ipaud/bolabol/codi/brand/boli.png

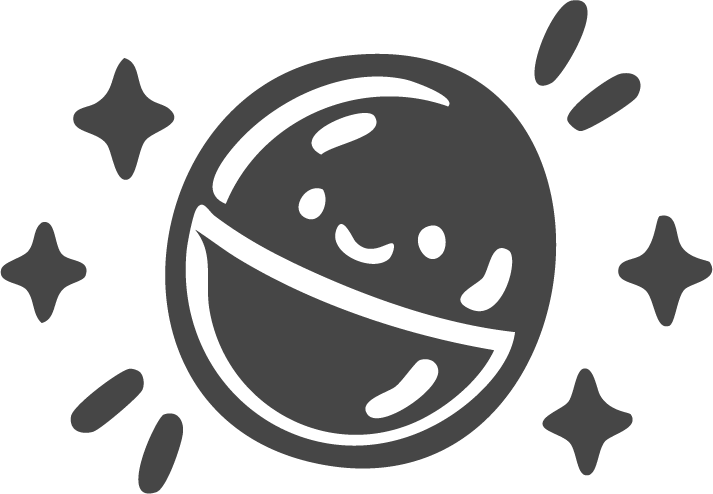
codi/brand/boli.png
