ipaud/bolabol/codi/brand/token_faces_preview.png

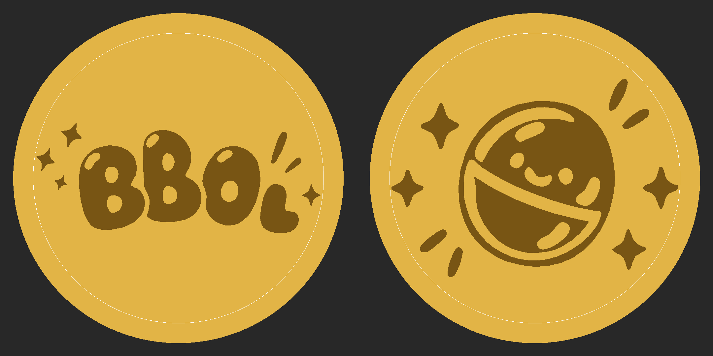
codi/brand/token_faces_preview.png
