ipaud/bolabol/docs/blueprints/despiece-v4.jpg

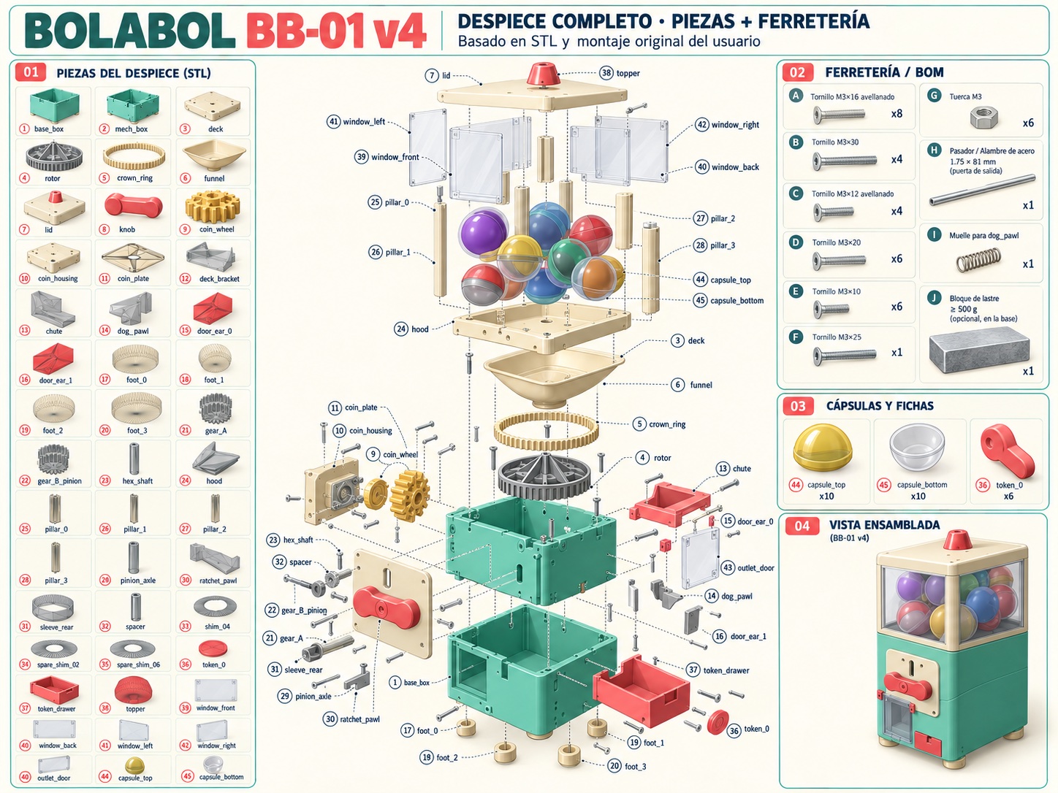
docs/blueprints/despiece-v4.jpg
