ipaud/bolabol/docs/blueprints/ficha-v4.jpg

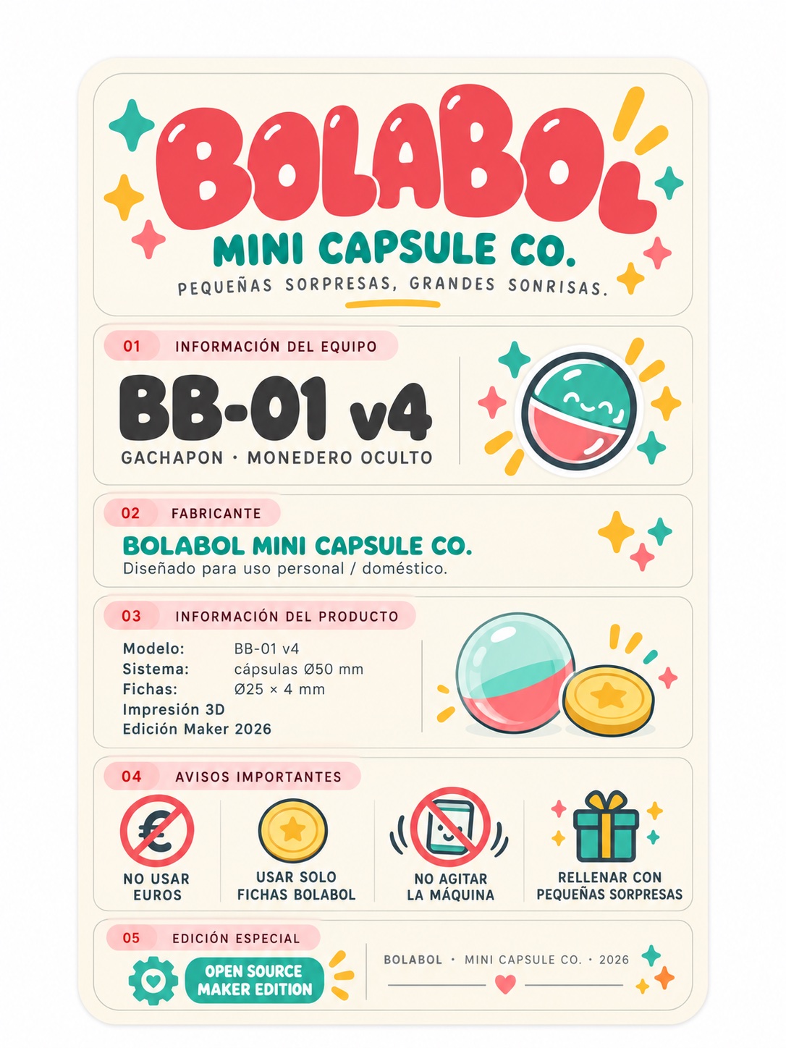
docs/blueprints/ficha-v4.jpg
