ipaud/bolabol/docs/blueprints/manivela-v1.jpg

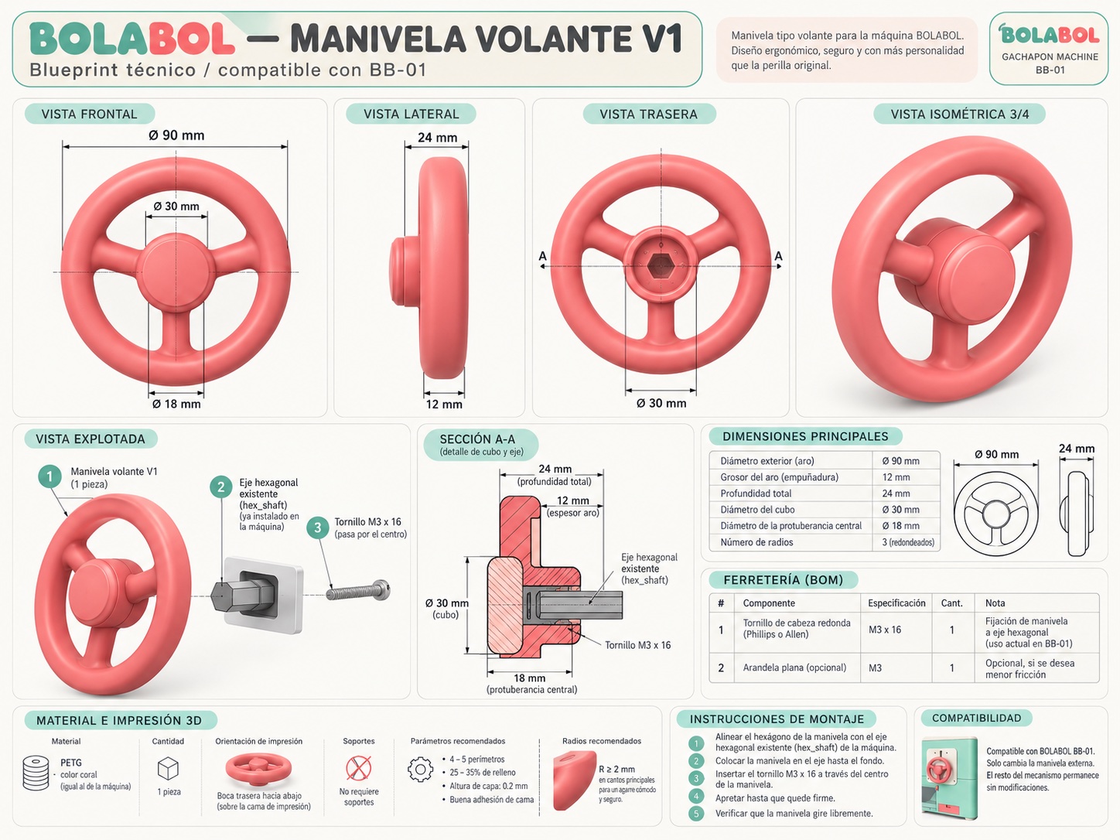
docs/blueprints/manivela-v1.jpg
