ipaud/bolabol/docs/brand/branding-maquina-paleta.jpg

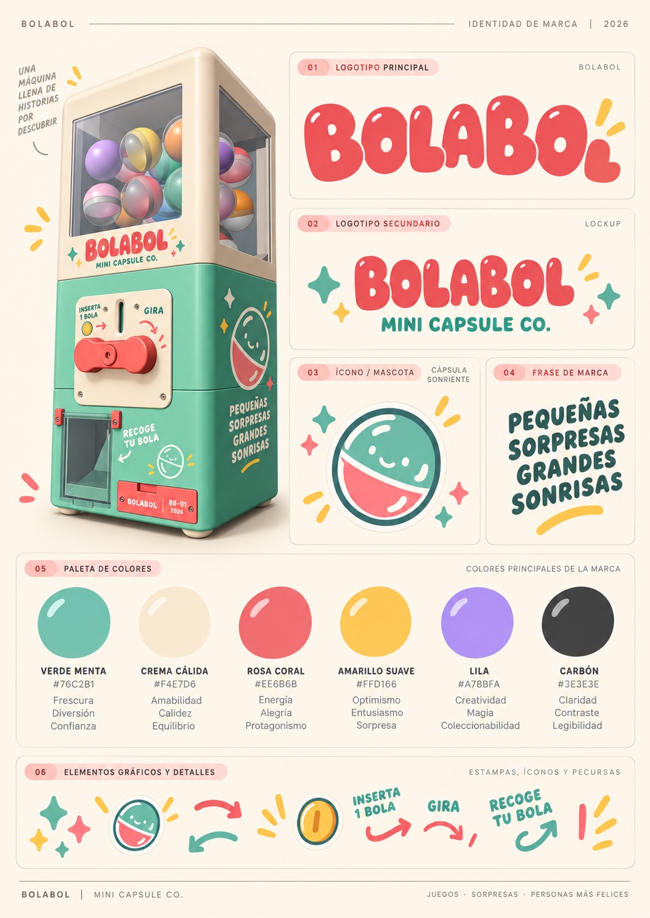
docs/brand/branding-maquina-paleta.jpg
