ipaud/bolabol/docs/brand/maquina-banana.jpg

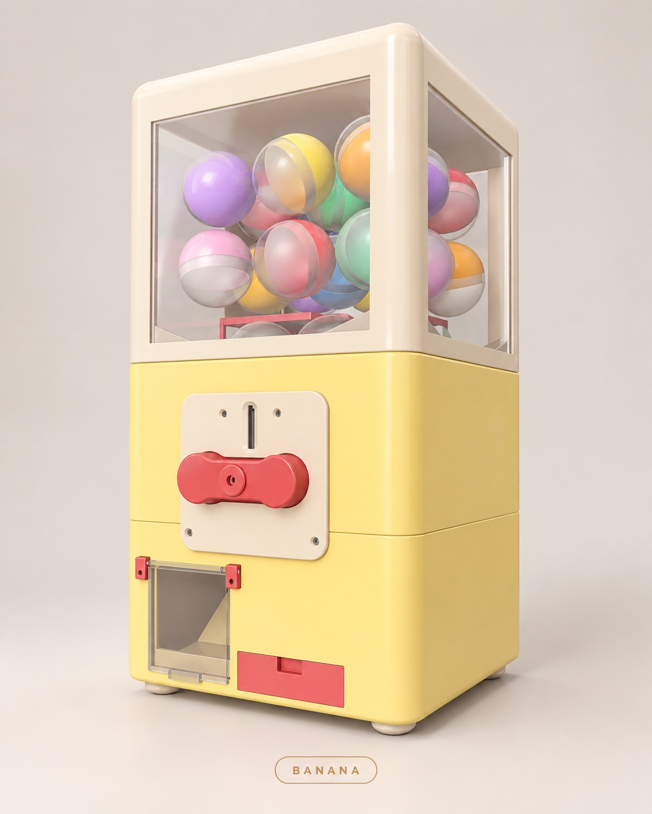
docs/brand/maquina-banana.jpg
