ipaud/bolabol/docs/brand/maquina-lavender.jpg

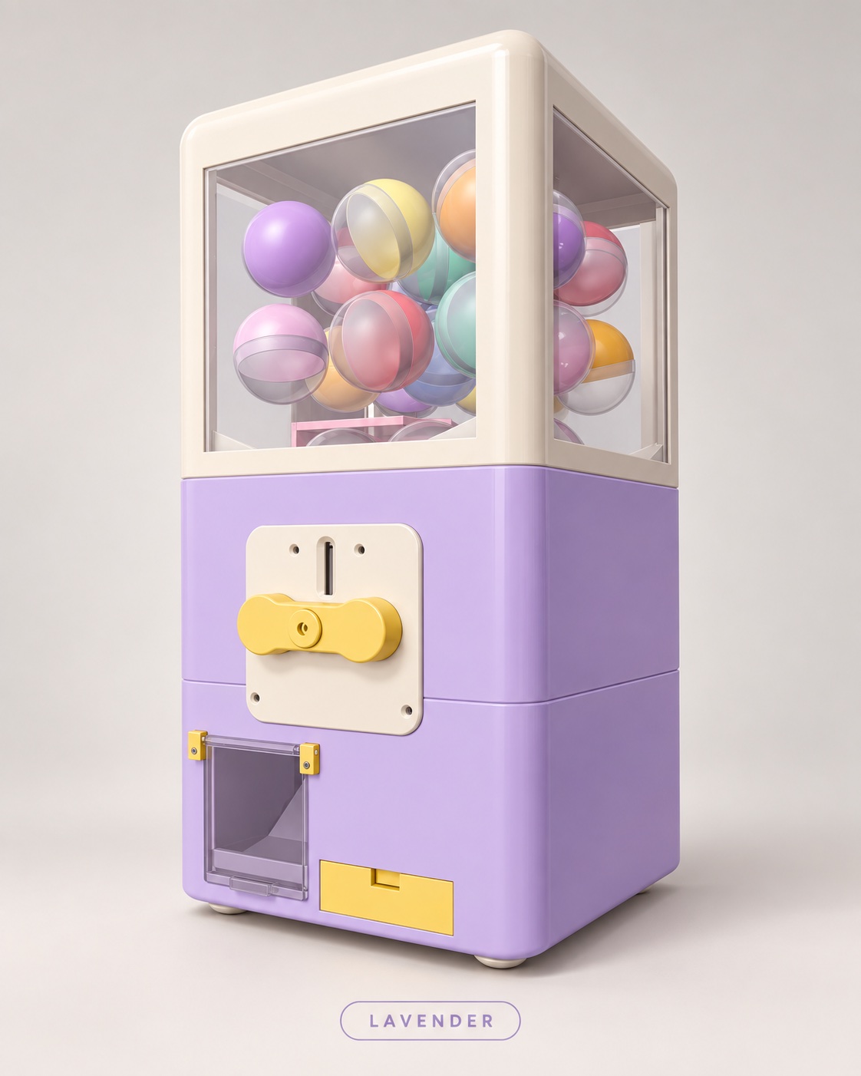
docs/brand/maquina-lavender.jpg
