ipaud/bolabol/docs/brand/maquina-mint.jpg

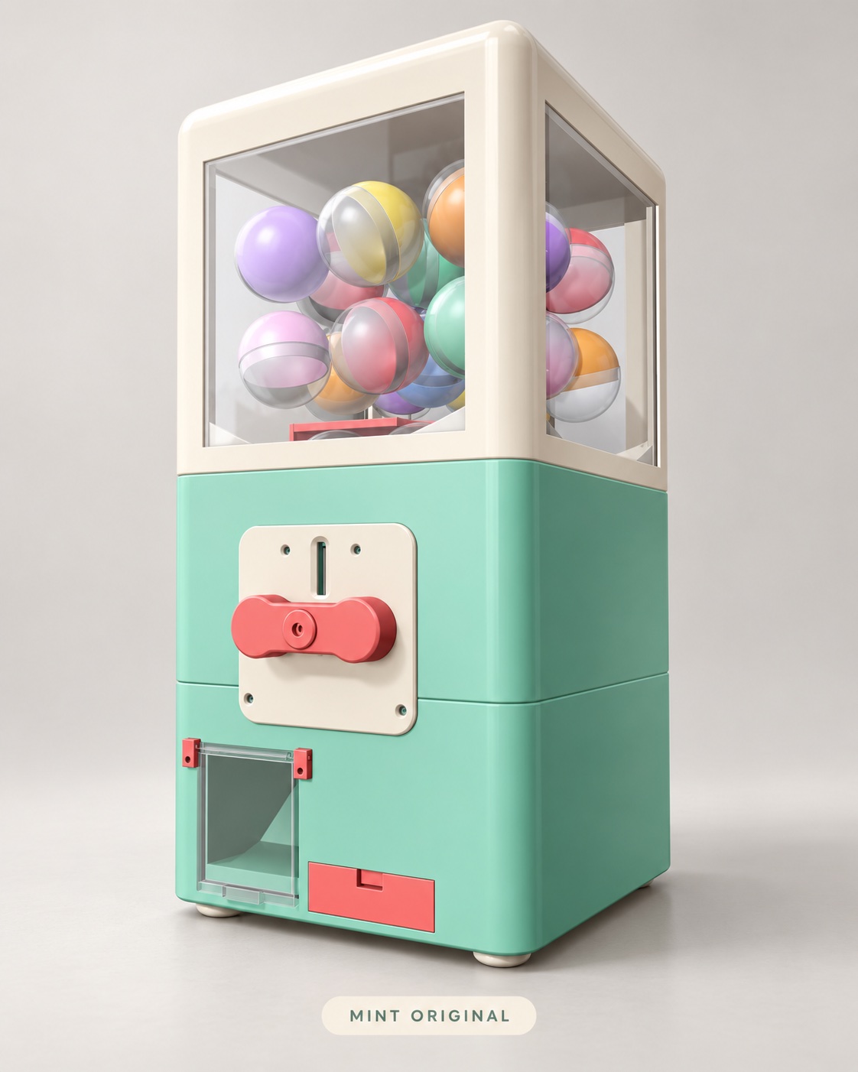
docs/brand/maquina-mint.jpg
