ipaud/bolabol/docs/brand/maquina-night.jpg

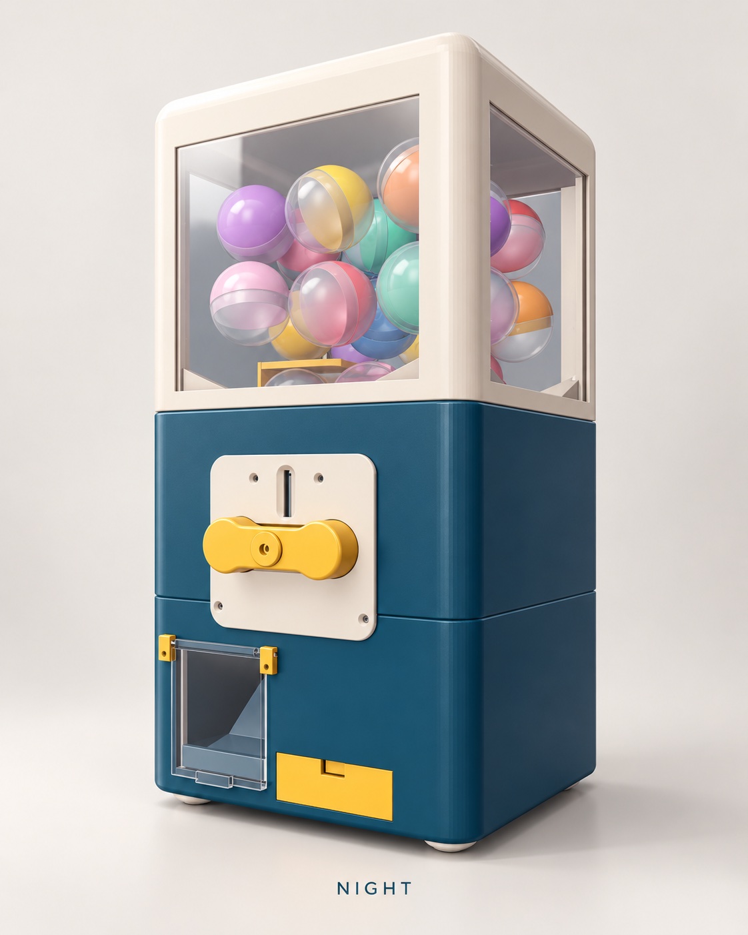
docs/brand/maquina-night.jpg
