ipaud/bolabol/docs/brand/maquina-sky.jpg

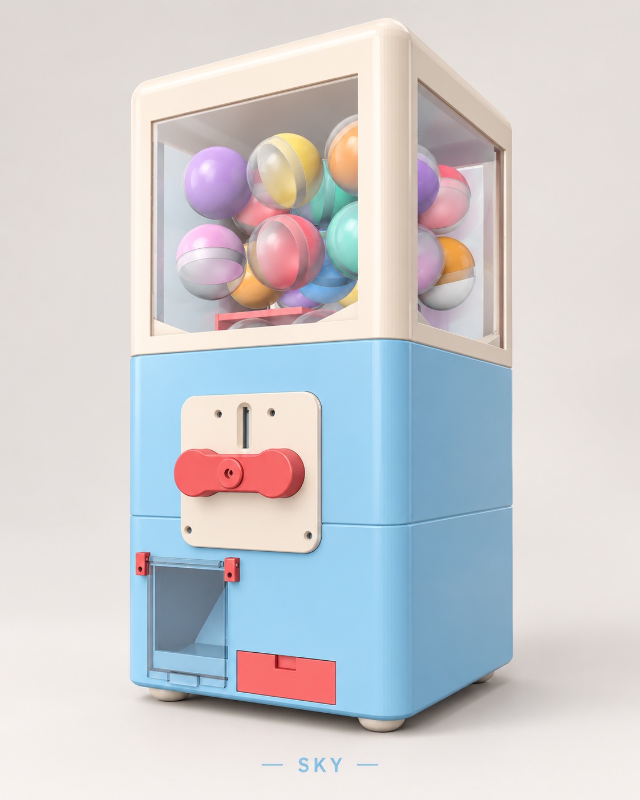
docs/brand/maquina-sky.jpg
