ipaud/bolabol/docs/brand/mascota-expresiones.jpg

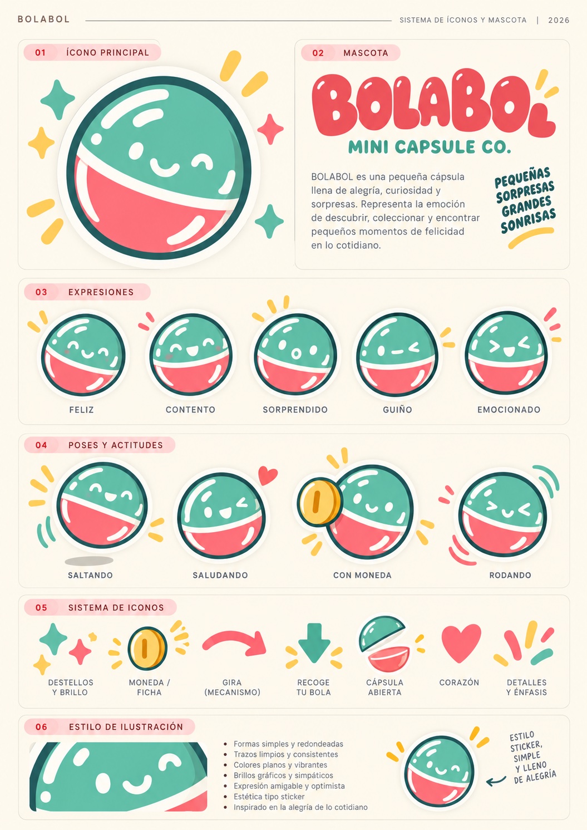
docs/brand/mascota-expresiones.jpg
