ipaud/bolabol/docs/brand/poster-maquina.jpg

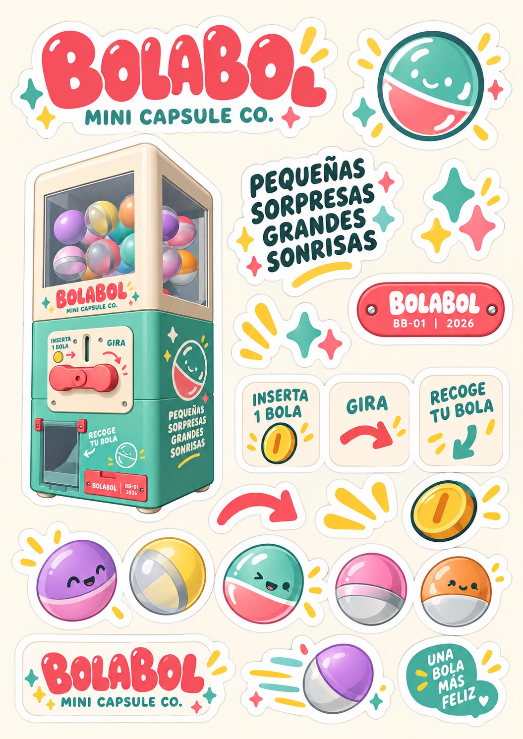
docs/brand/poster-maquina.jpg
