ipaud/bolabol/docs/brand/sistema-tipografico.jpg

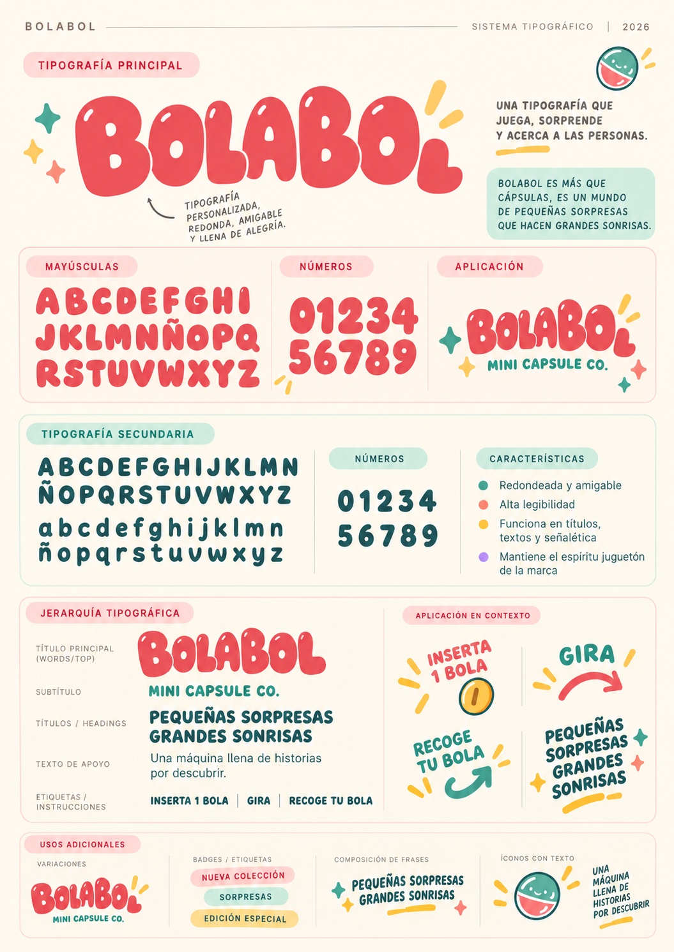
docs/brand/sistema-tipografico.jpg
