ipaud/bolabol/docs/images/v4_moneda.jpg

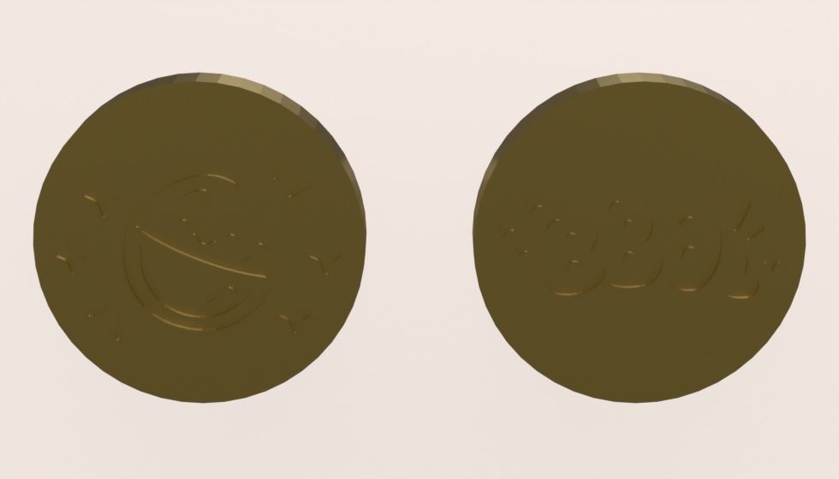
docs/images/v4_moneda.jpg
