ipaud/bolabol/2monedes/mech_box.stl

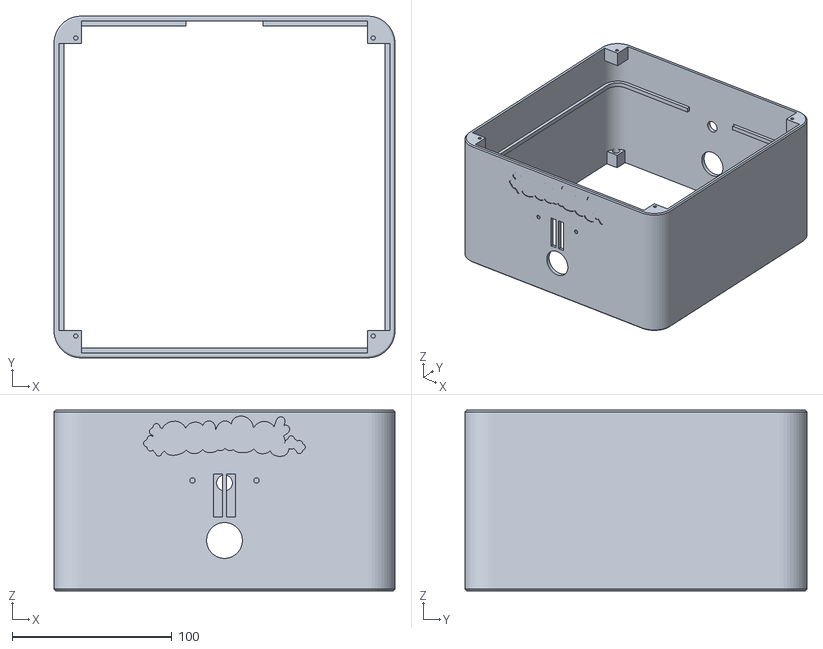
[picture p20: CAD file, 2026-10-04]
2monedes/mech_box.stl
213.4 x 213.9 x 113.0
