ipaud/bolabol/2monedes/proves/proves_5_moneda_A_PLA.3mf

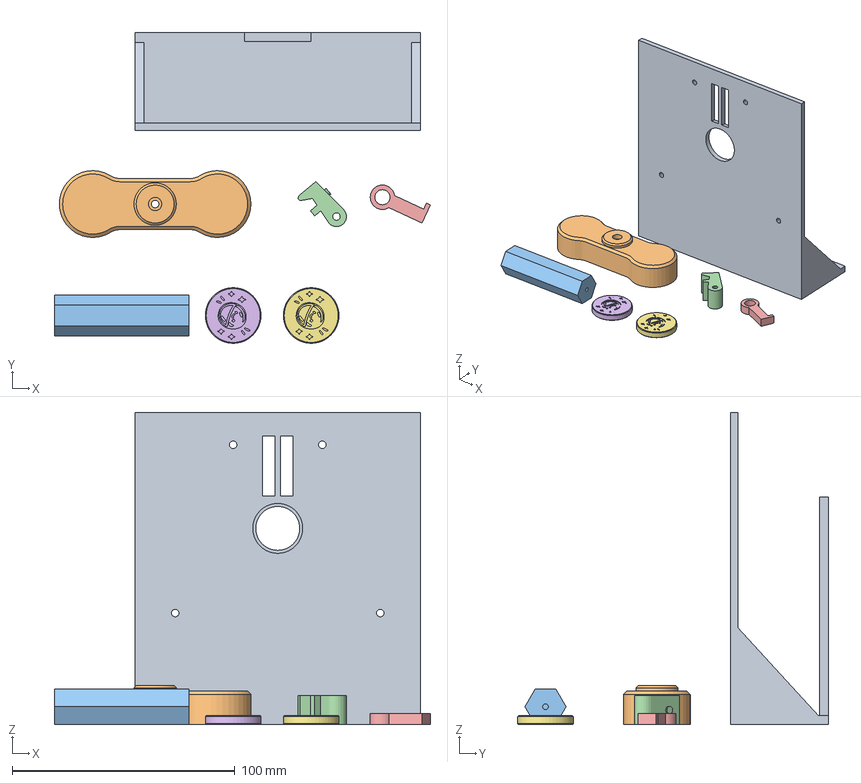
[picture p21: CAD file, 2026-10-04]
2monedes/proves/proves_5_moneda_A_PLA.3mf
168.7 x 139.4 x 140.0 mm
test_coin_jig
knob
test_hex_coupon_coin
dog_pawl
ratchet_pawl
token_0
token_0_b
