ipaud/bolabol/imprimir/llits/llit_11_mecanisme.3mf

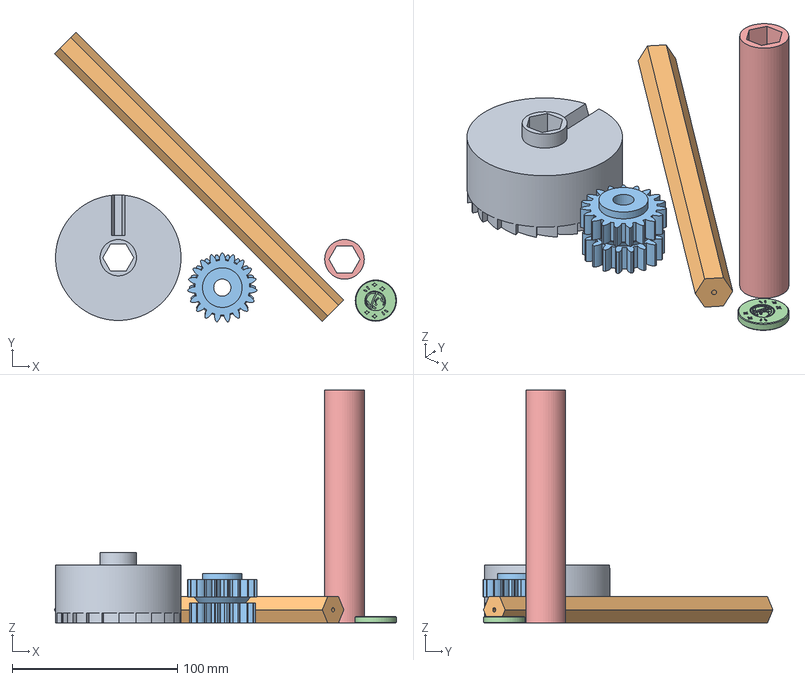
[picture p22: CAD file, 2026-10-04]
imprimir/llits/llit_11_mecanisme.3mf
207.1 x 175.5 x 141.1 mm
coin_wheel
hex_shaft
gear_B_pinion
token_0_6
spacer
