ipaud/bolabol/imprimir/logo_sparkles_mint.stl

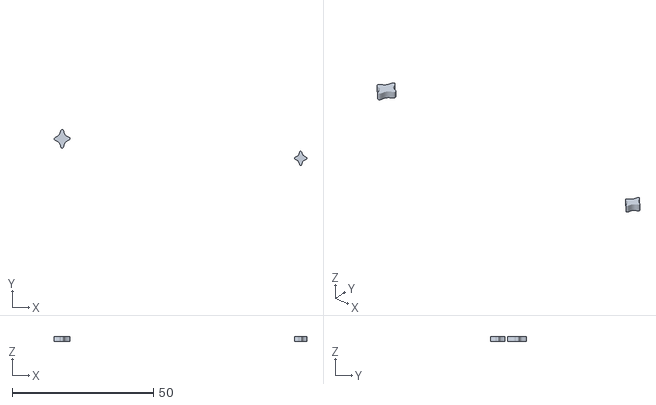
[picture p23: CAD file, 2026-10-04]
imprimir/logo_sparkles_mint.stl
89.5 x 12.8 x 1.80
