ipaud/bolabol/stl/proves/proves_6_moneda_B.3mf

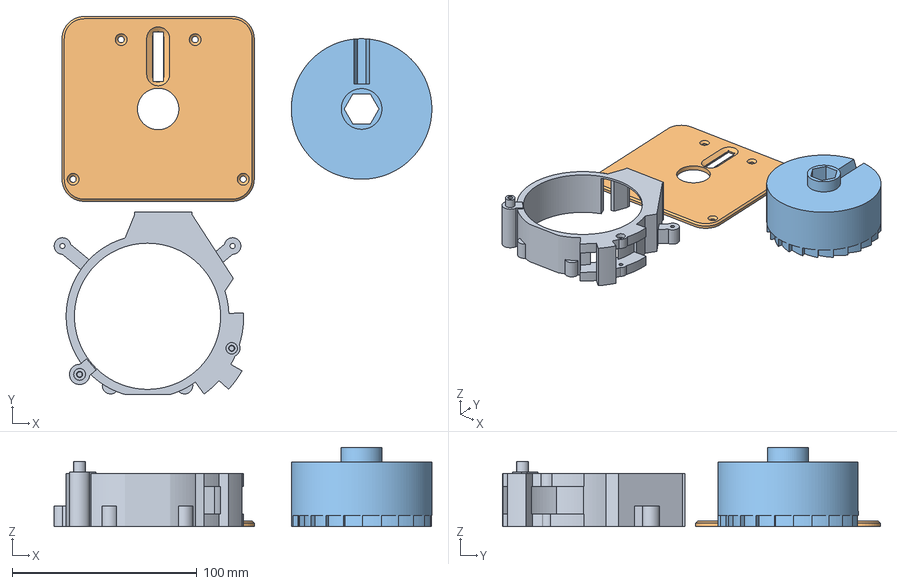
[picture p24: CAD file, 2026-10-04]
stl/proves/proves_6_moneda_B.3mf
204.2 x 204.4 x 42.8 mm
coin_housing
coin_plate
coin_wheel
