ipaud/bolabol/stl/spacer.stl

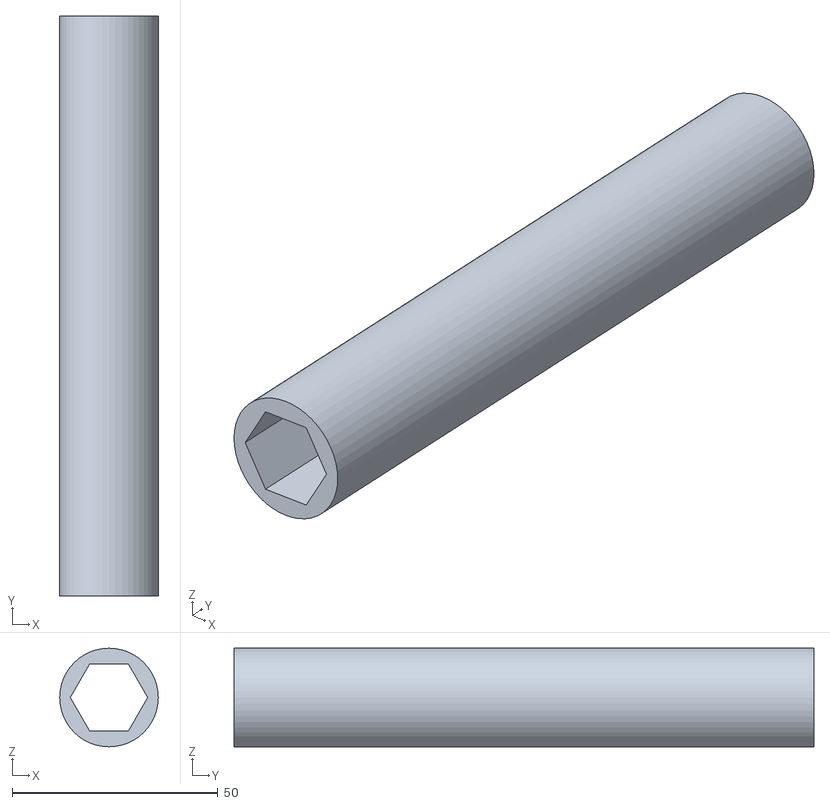
[picture p25: CAD file, 2026-10-04]
stl/spacer.stl
24.0 x 141.1 x 24.0
