ipaud/bolabol/2monedes/coin_plate.stl

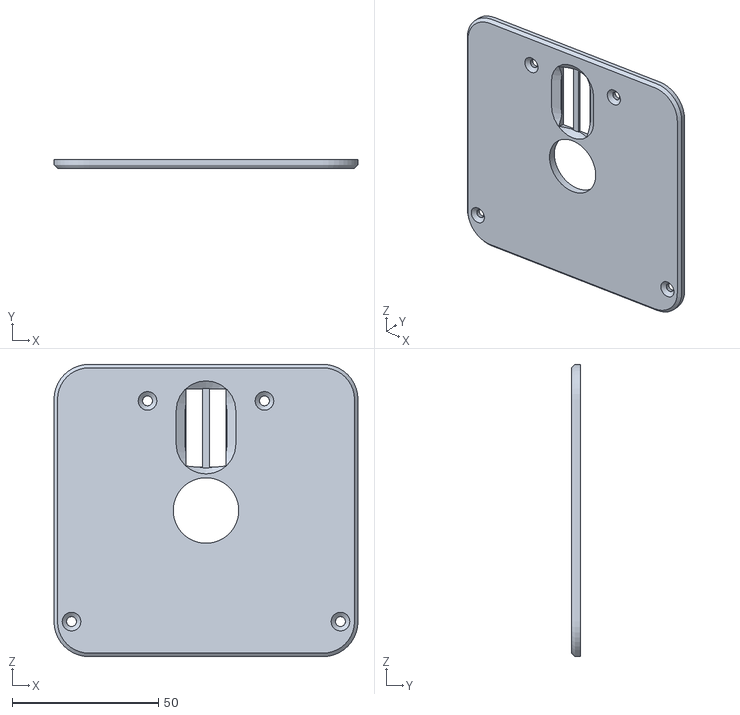
[picture p26: CAD file, 2026-10-04]
2monedes/coin_plate.stl
104.0 x 3.00 x 100.0
