ipaud/bolabol/2monedes/proves/proves_6_moneda_B_PLA.3mf

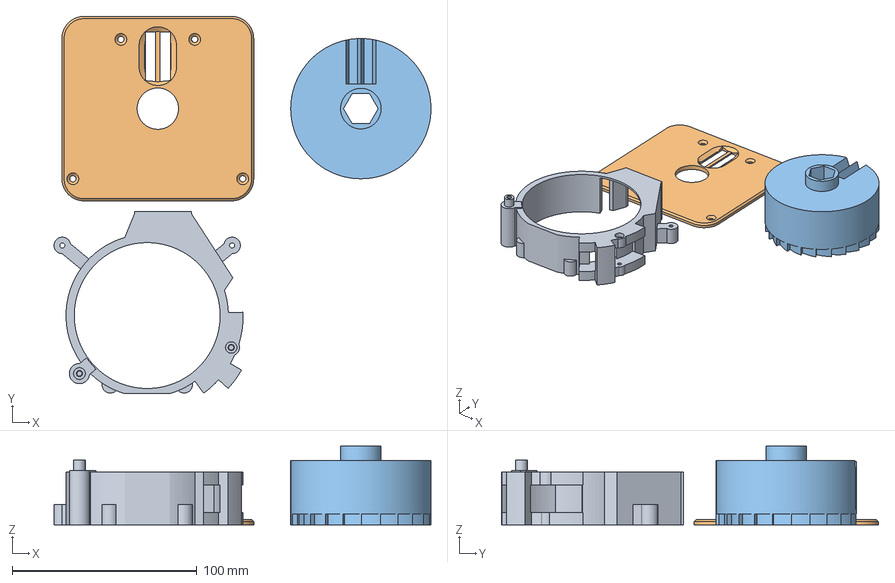
[picture p27: CAD file, 2026-10-04]
2monedes/proves/proves_6_moneda_B_PLA.3mf
204.2 x 204.4 x 42.8 mm
coin_housing
coin_plate
coin_wheel
