ipaud/bolabol/imprimir/llits/llit_18_corall.3mf

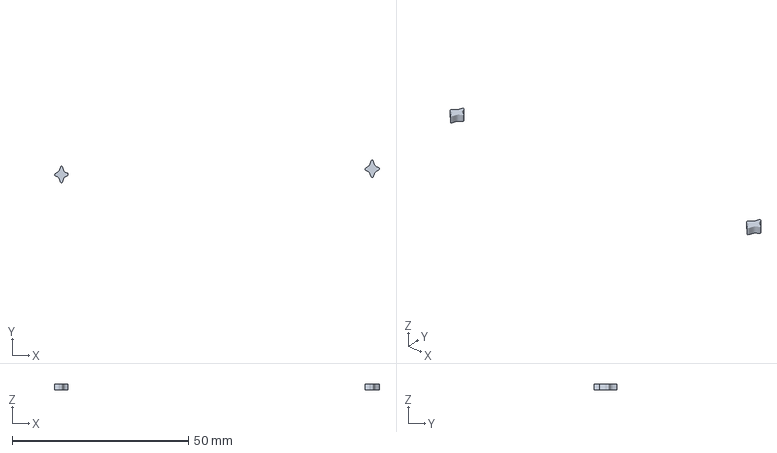
[picture p28: CAD file, 2026-10-04]
imprimir/llits/llit_18_corall.3mf
92.1 x 6.57 x 1.80 mm
