ipaud/bolabol/stl/gear_A.stl

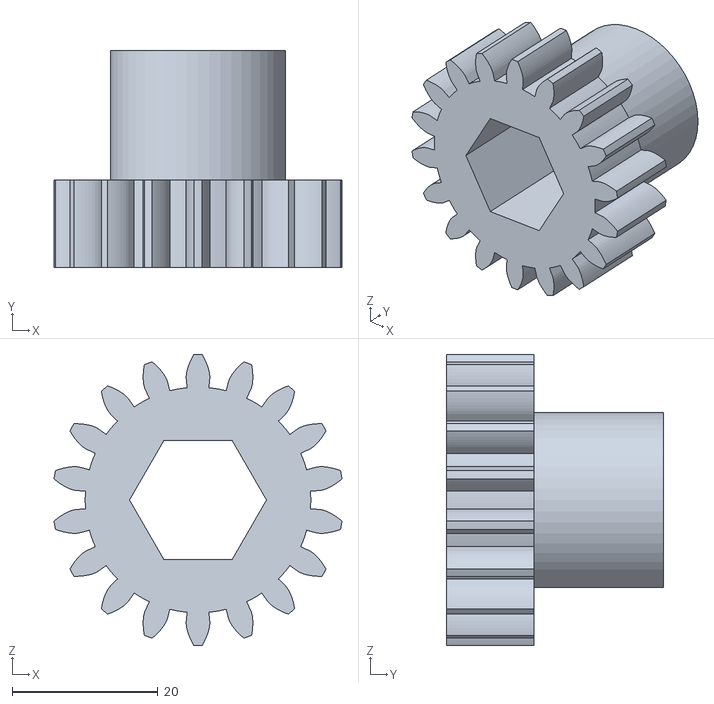
[picture p29: CAD file, 2026-10-04]
stl/gear_A.stl
39.6 x 29.8 x 40.0
