ipaud/bolabol/stl/proves/test_hex_coupon_gears.stl

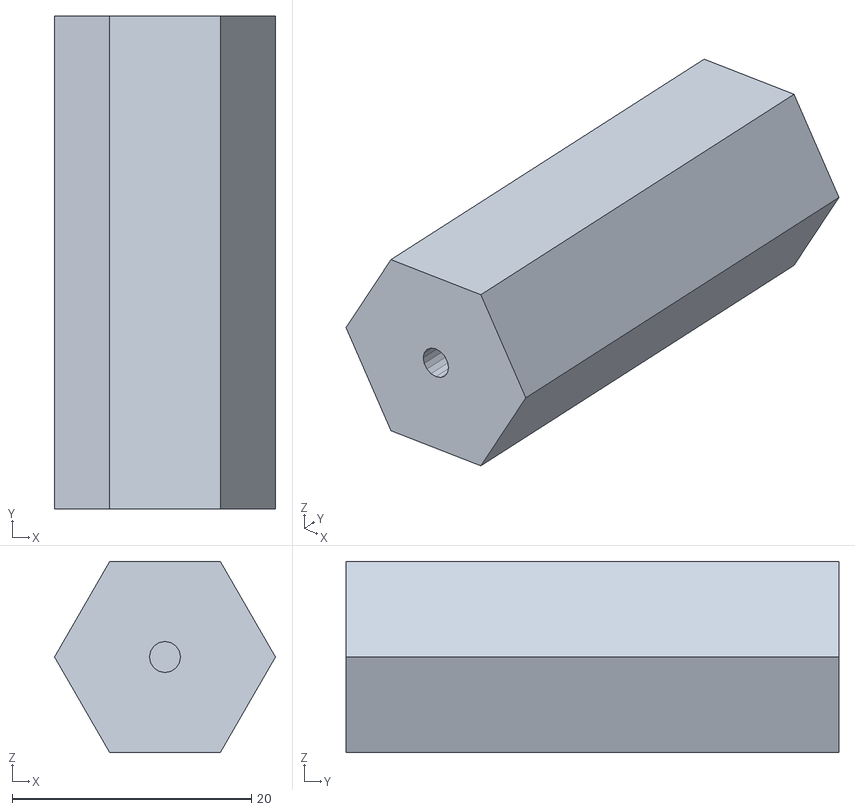
[picture p30: CAD file, 2026-10-04]
stl/proves/test_hex_coupon_gears.stl
18.5 x 41.2 x 16.0
