ipaud/bolabol/2monedes/coin_wheel.stl

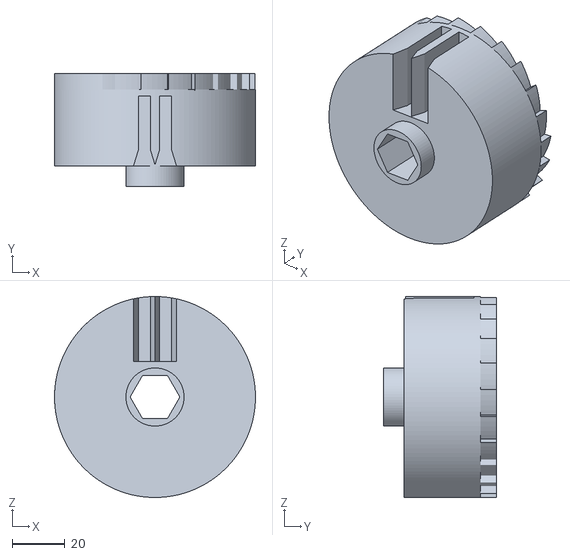
[picture p31: CAD file, 2026-10-04]
2monedes/coin_wheel.stl
76.0 x 42.8 x 76.0
