ipaud/bolabol/2monedes/proves/test_coin_jig.stl

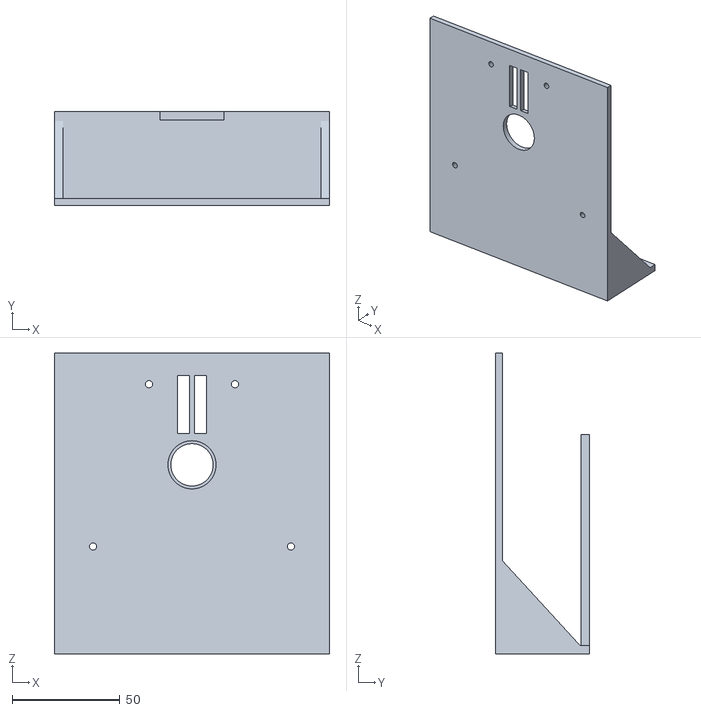
[picture p32: CAD file, 2026-10-04]
2monedes/proves/test_coin_jig.stl
128.0 x 43.8 x 140.0
