ipaud/bolabol/imprimir/coin_housing.stl

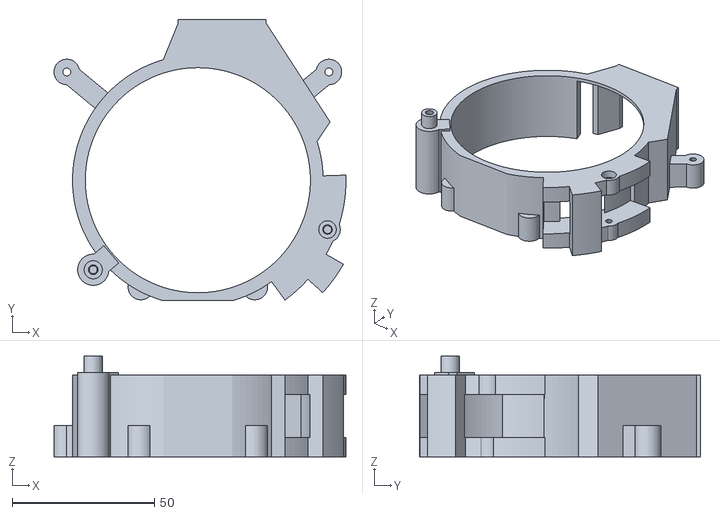
[picture p33: CAD file, 2026-10-04]
imprimir/coin_housing.stl
102.5 x 98.8 x 35.3
