ipaud/bolabol/imprimir/llits/llit_16_groc.3mf

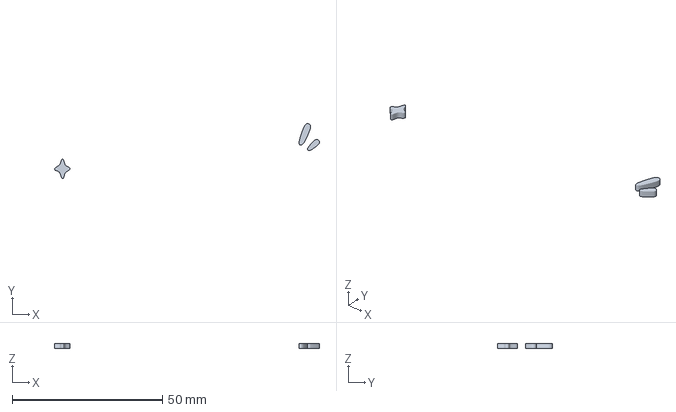
[picture p34: CAD file, 2026-10-04]
imprimir/llits/llit_16_groc.3mf
88.2 x 18.3 x 1.80 mm
