ipaud/bolabol/stl/pillar_2.stl

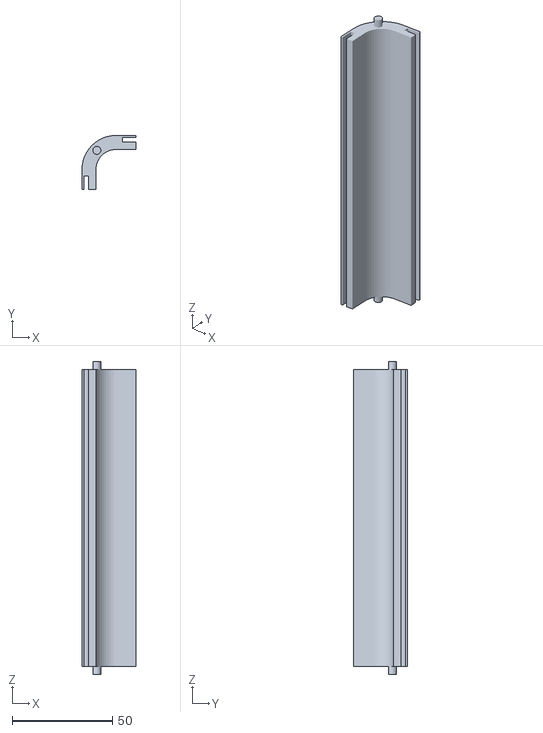
[picture p35: CAD file, 2026-10-04]
stl/pillar_2.stl
27.0 x 27.0 x 156.0
