ipaud/bolabol/stl/proves/test_hex_coupon_coin.stl

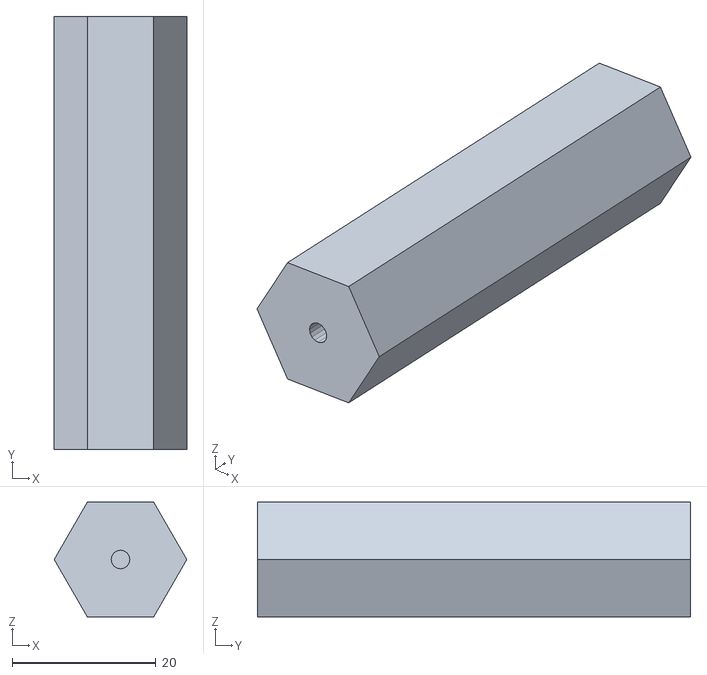
[picture p36: CAD file, 2026-10-04]
stl/proves/test_hex_coupon_coin.stl
18.5 x 60.3 x 16.0
