ipaud/bolabol/imprimir/llits/llit_12_transparent.3mf

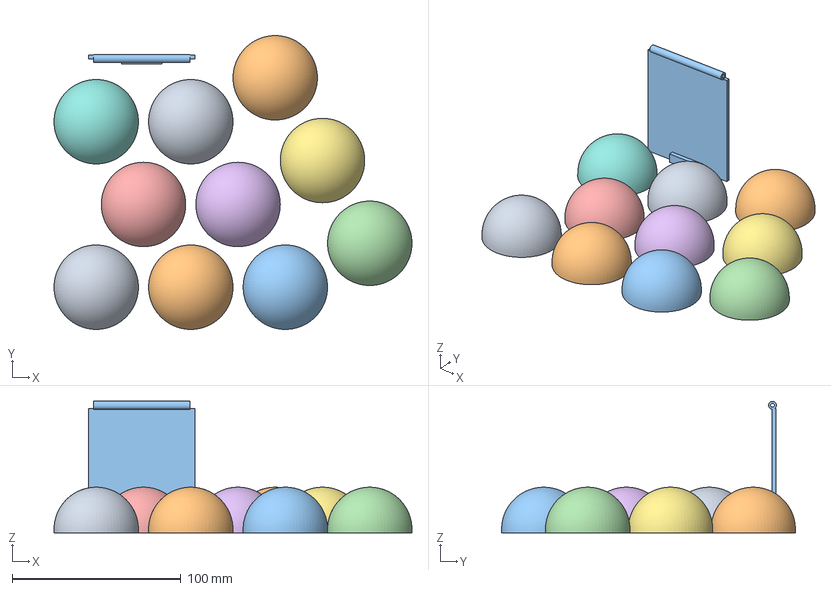
[picture p37: CAD file, 2026-10-04]
imprimir/llits/llit_12_transparent.3mf
212.0 x 174.0 x 77.9 mm
capsule_top
capsule_top_2
capsule_top_3
capsule_top_4
capsule_top_5
capsule_top_6
capsule_top_7
capsule_top_8
capsule_top_9
capsule_top_10
outlet_door
