ipaud/bolabol/stl/proves/test_gear_jig.stl

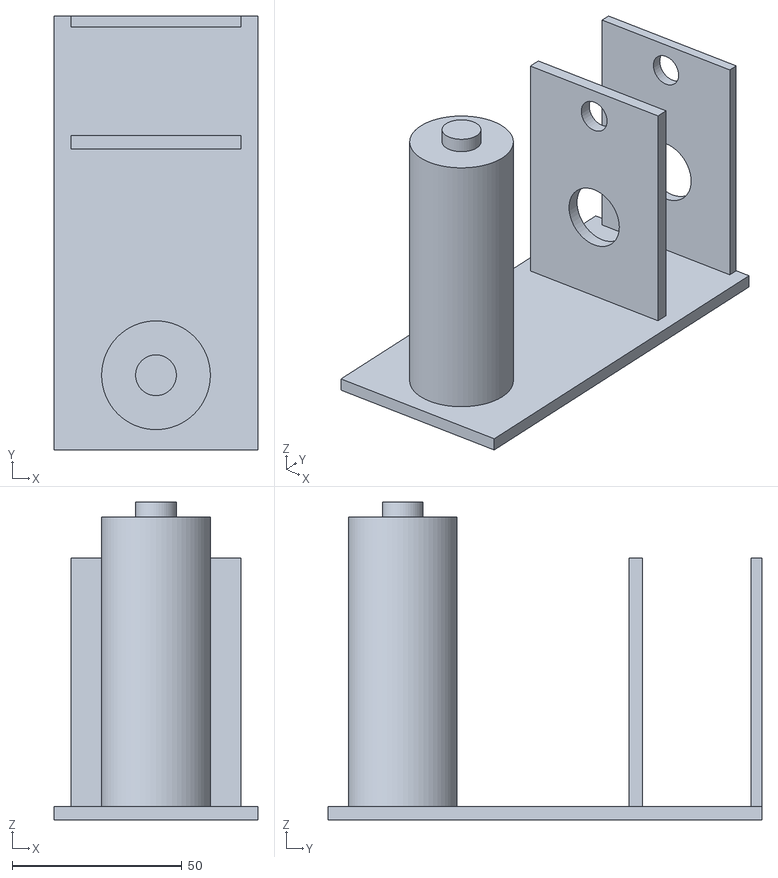
[picture p38: CAD file, 2026-10-04]
stl/proves/test_gear_jig.stl
60.0 x 127.7 x 93.5
