ipaud/bolabol/imprimir/llits/llit_19_monedes.3mf

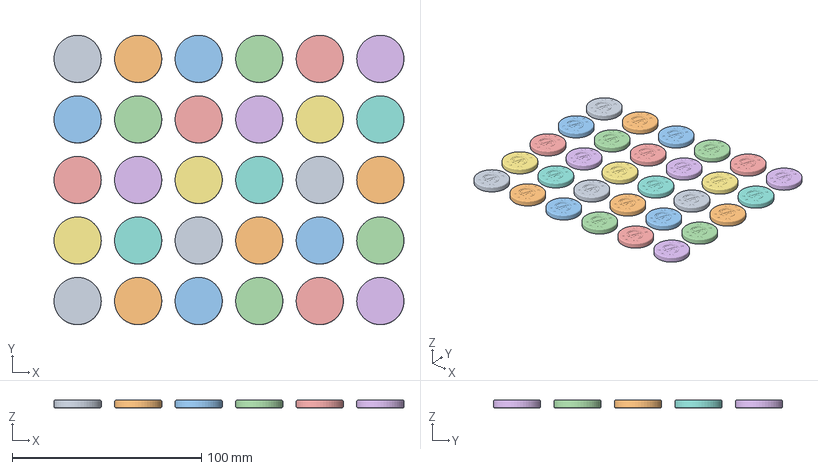
[picture p39: CAD file, 2026-10-04]
imprimir/llits/llit_19_monedes.3mf
185.0 x 153.0 x 4.00 mm
token_0
token_0_02
token_0_03
token_0_04
token_0_05
token_0_06
token_0_07
token_0_08
token_0_09
token_0_10
token_0_11
token_0_12
token_0_13
token_0_14
token_0_15
token_0_16
token_0_17
token_0_18
token_0_19
token_0_20
token_0_21
token_0_22
token_0_23
token_0_24
token_0_25
token_0_26
token_0_27
token_0_28
token_0_29
token_0_30
