ipaud/bolabol/imprimir/token_drawer.stl

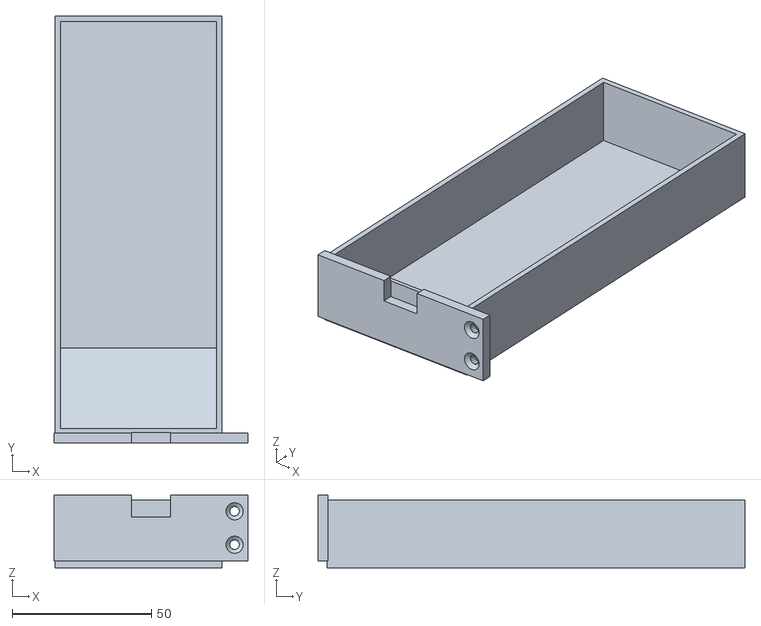
[picture p40: CAD file, 2026-10-04]
imprimir/token_drawer.stl
69.6 x 153.1 x 26.1
