ipaud/bolabol/imprimir/llits/llit_20_chute.3mf

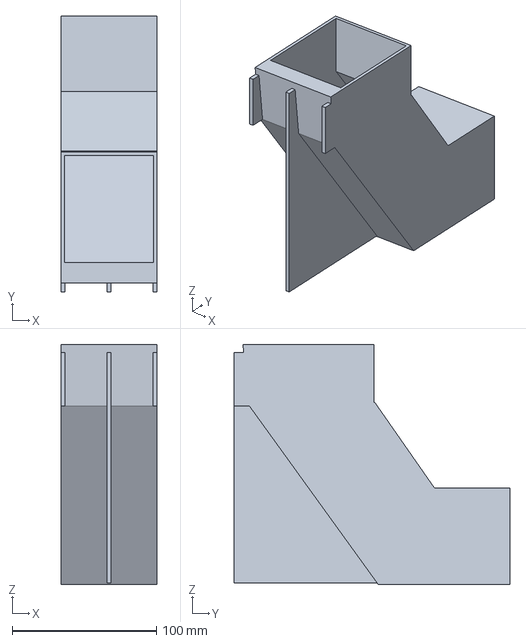
[picture p41: CAD file, 2026-10-04]
imprimir/llits/llit_20_chute.3mf
66.8 x 191.2 x 166.4 mm
