ipaud/bolabol/stl/proves/test_crown_sector.stl

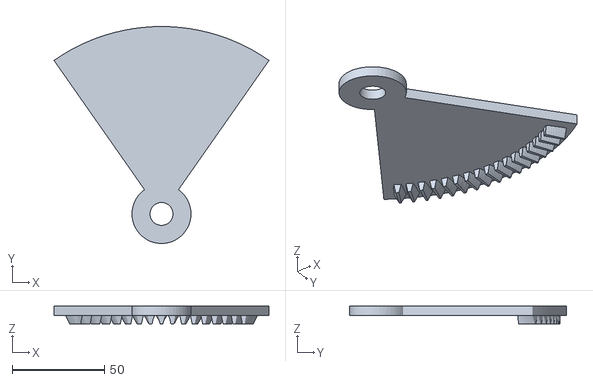
[picture p42: CAD file, 2026-10-04]
stl/proves/test_crown_sector.stl
116.4 x 117.5 x 9.50
