ipaud/bolabol/imprimir/capsule_bottom_x10.stl

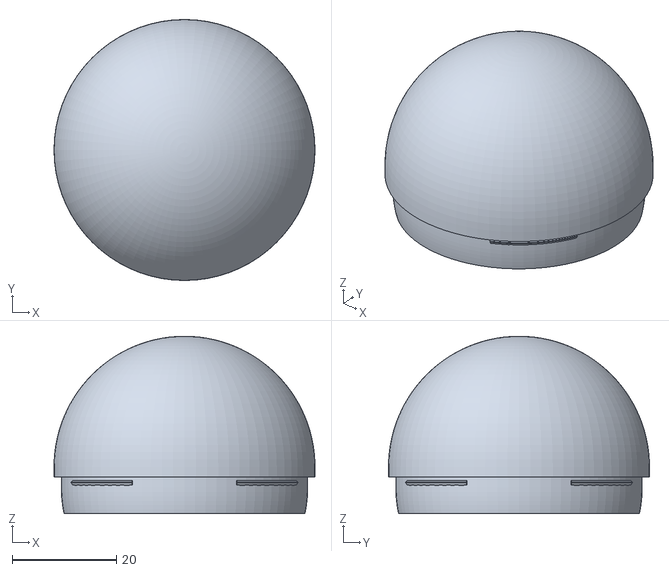
[picture p43: CAD file, 2026-10-04]
imprimir/capsule_bottom_x10.stl
50.0 x 50.0 x 34.0
