ipaud/bolabol/imprimir/llits/llit_10_mecanisme.3mf

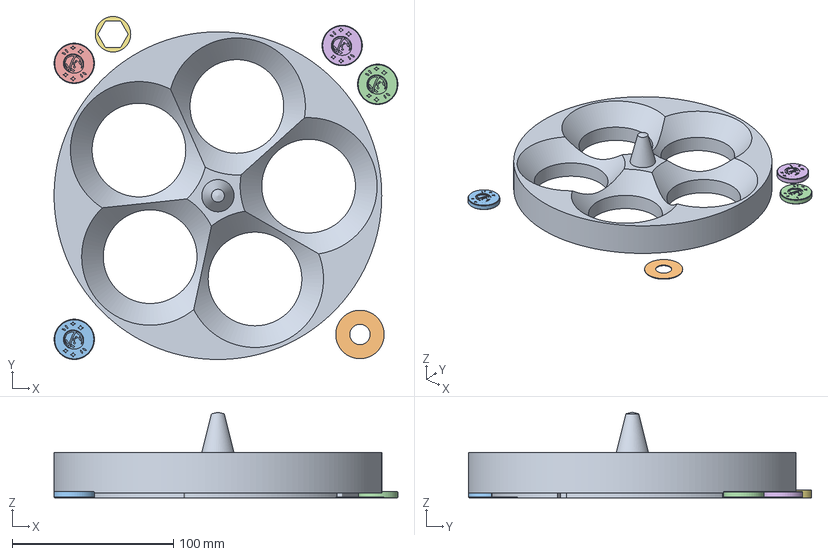
[picture p44: CAD file, 2026-10-04]
imprimir/llits/llit_10_mecanisme.3mf
213.0 x 212.5 x 53.0 mm
rotor
spare_shim_06
token_0_2
token_0_3
token_0_4
token_0_5
sleeve_rear
