ipaud/bolabol/stl/crown_ring.stl

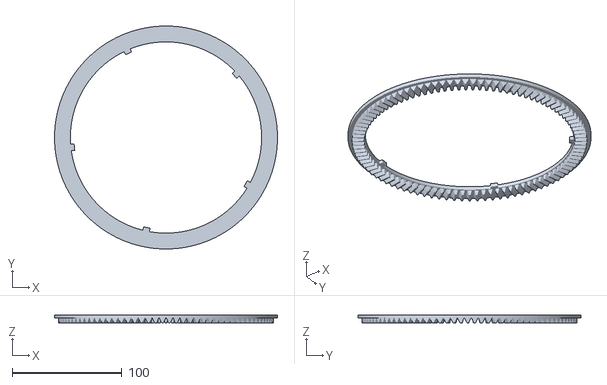
[picture p45: CAD file, 2026-10-04]
stl/crown_ring.stl
203.0 x 203.0 x 7.50
