ipaud/bolabol/imprimir/llits/llit_13_capsules.3mf

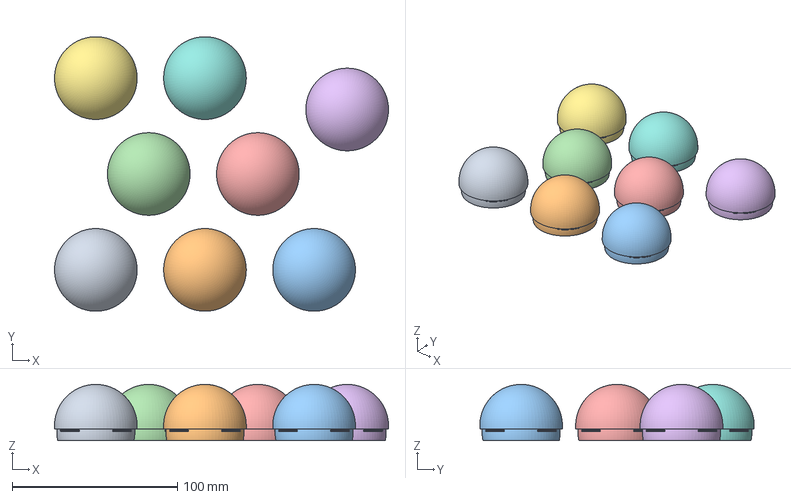
[picture p46: CAD file, 2026-10-04]
imprimir/llits/llit_13_capsules.3mf
202.0 x 166.0 x 34.0 mm
capsule_bottom
capsule_bottom_2
capsule_bottom_3
capsule_bottom_4
capsule_bottom_5
capsule_bottom_6
capsule_bottom_7
capsule_bottom_8
