ipaud/bolabol/imprimir/window_front.stl

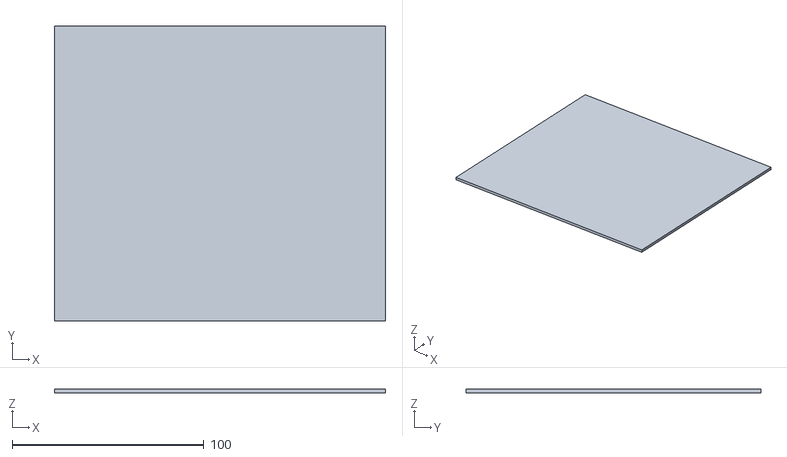
[picture p47: CAD file, 2026-10-04]
imprimir/window_front.stl
172.4 x 153.5 x 2.00
