ipaud/bolabol/imprimir/funnel.stl

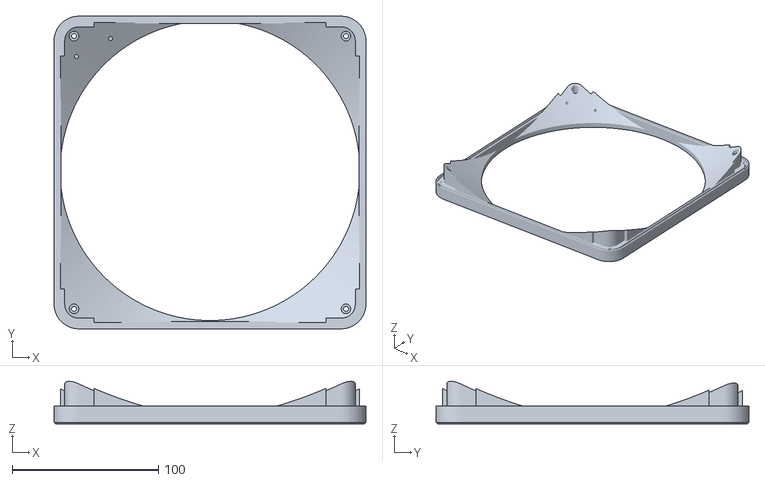
[picture p48: CAD file, 2026-10-04]
imprimir/funnel.stl
213.4 x 213.9 x 29.1
