ipaud/bolabol/stl/base_box.stl

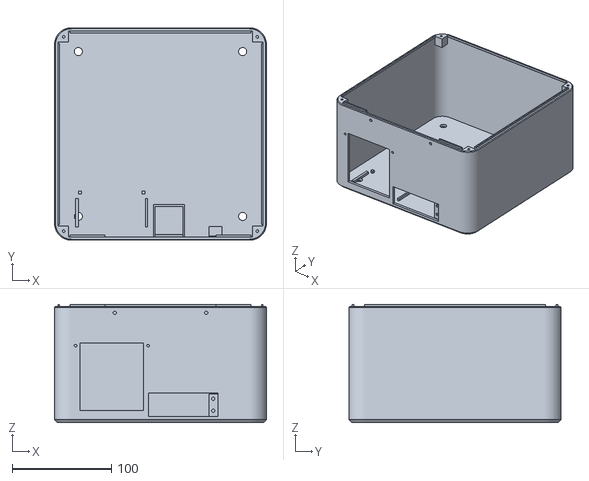
[picture p49: CAD file, 2026-10-04]
stl/base_box.stl
213.4 x 213.9 x 119.0
