ipaud/bolabol/stl/token_0.stl

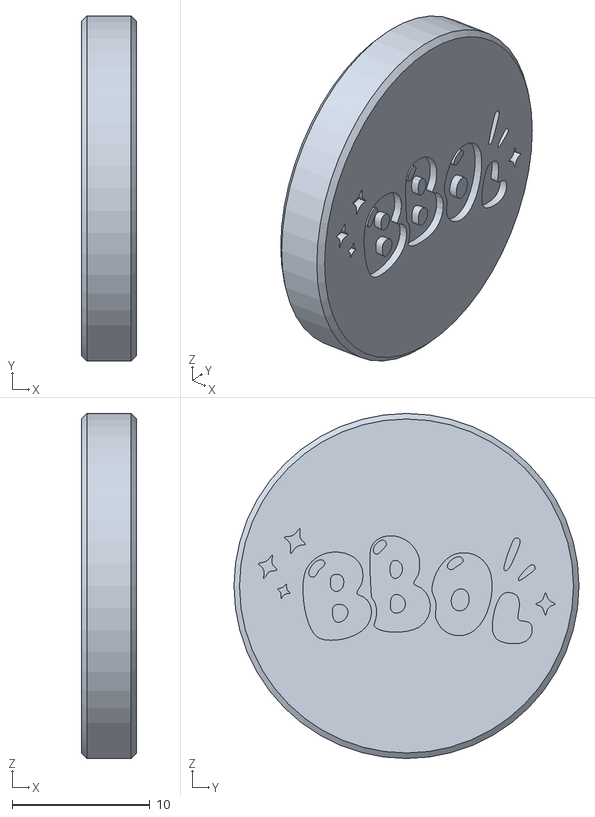
[picture p50: CAD file, 2026-10-04]
stl/token_0.stl
4.00 x 25.0 x 25.0
