ipaud/bolabol/imprimir/llits/llit_14_capsules.3mf

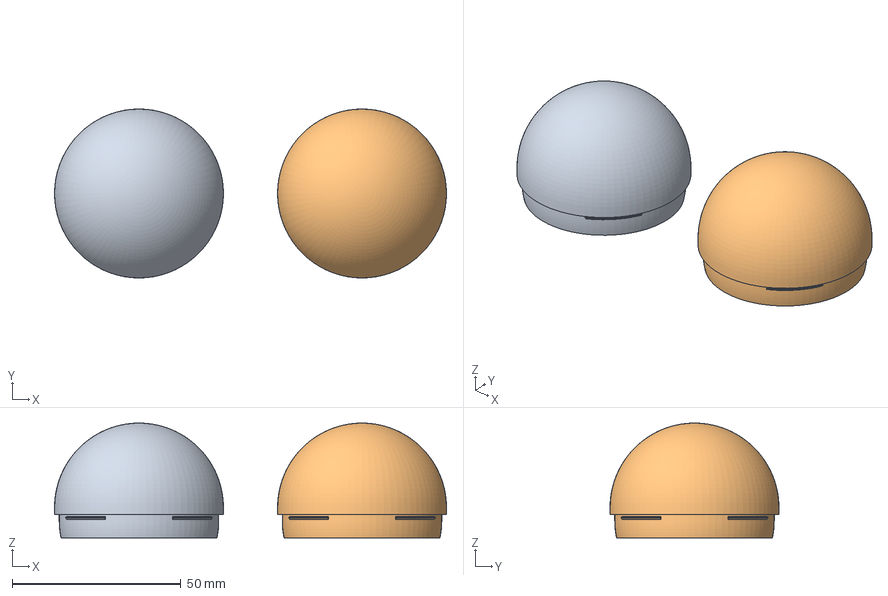
[picture p51: CAD file, 2026-10-04]
imprimir/llits/llit_14_capsules.3mf
116.0 x 50.0 x 34.0 mm
capsule_bottom_9
capsule_bottom_10
