ipaud/bolabol/imprimir/hex_shaft.stl

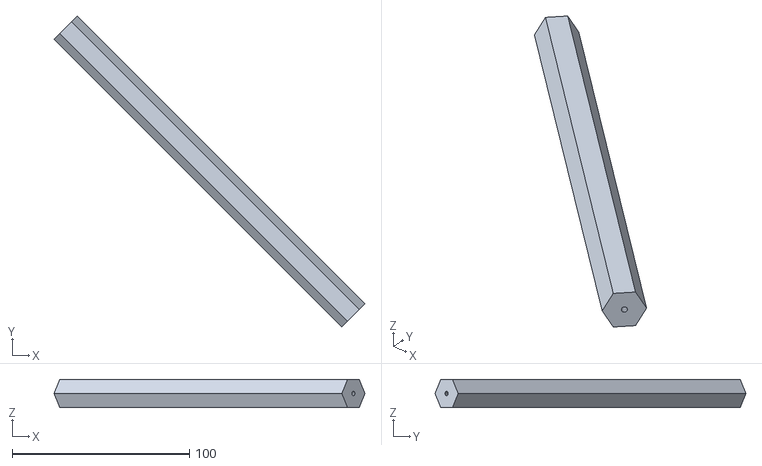
[picture p52: CAD file, 2026-10-04]
imprimir/hex_shaft.stl
175.3 x 175.3 x 16.0
