ipaud/bolabol/imprimir/llits/llit_03_menta.3mf

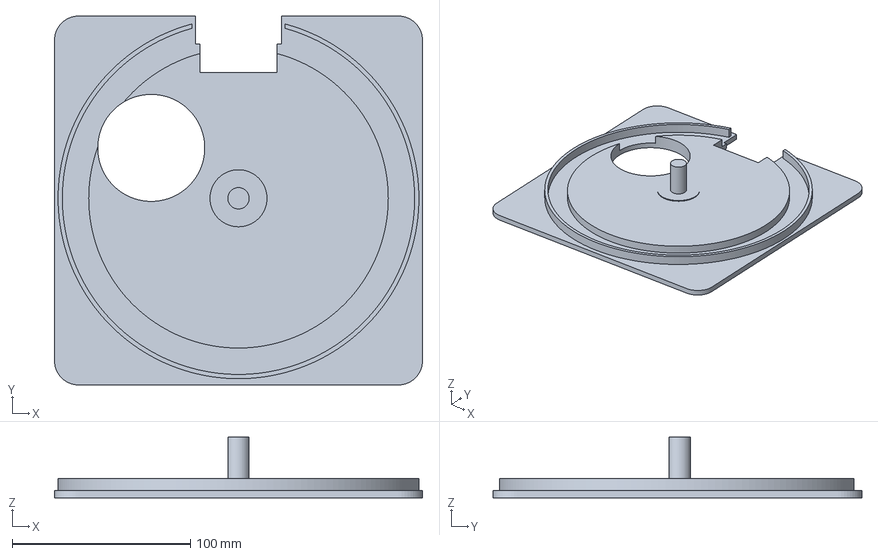
[picture p53: CAD file, 2026-10-04]
imprimir/llits/llit_03_menta.3mf
206.4 x 206.9 x 34.0 mm
