ipaud/bolabol/stl/foot_1.stl

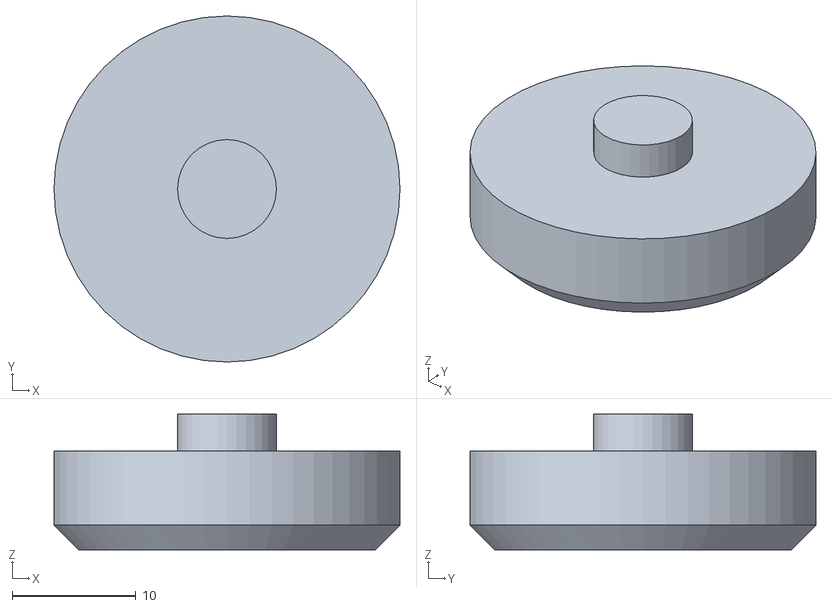
[picture p54: CAD file, 2026-10-04]
stl/foot_1.stl
28.0 x 28.0 x 11.0
