ipaud/bolabol/imprimir/llits/llit_07_crema.3mf

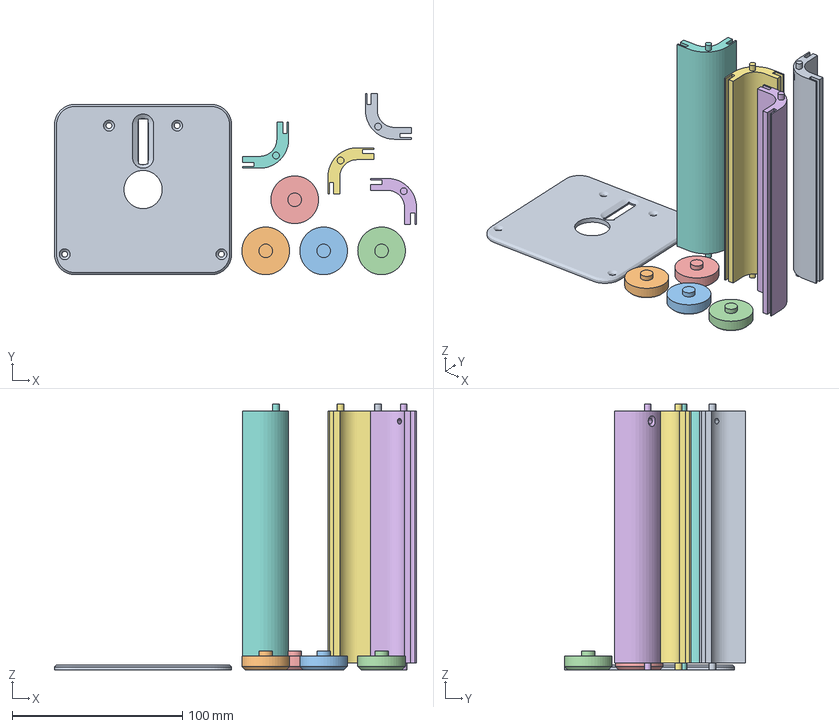
[picture p55: CAD file, 2026-10-04]
imprimir/llits/llit_07_crema.3mf
212.5 x 106.5 x 156.0 mm
coin_plate
foot_1
foot_2
foot_0
foot_3
pillar_1
pillar_2
pillar_0
pillar_3
