ipaud/bolabol/imprimir/lid.stl

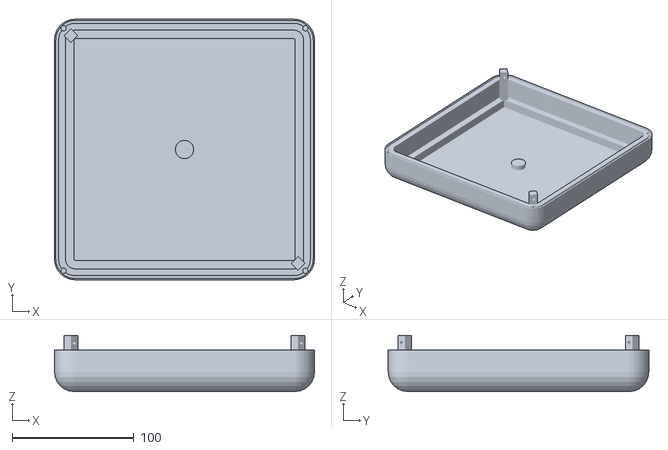
[picture p56: CAD file, 2026-10-04]
imprimir/lid.stl
213.4 x 213.9 x 46.0
