ipaud/bolabol/imprimir/llits/llit_15_logo.3mf

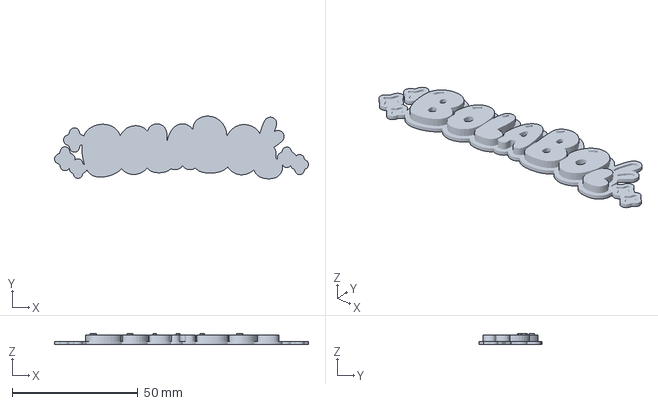
[picture p57: CAD file, 2026-10-04]
imprimir/llits/llit_15_logo.3mf
100.9 x 24.9 x 4.20 mm
