ipaud/bolabol/imprimir/hood.stl

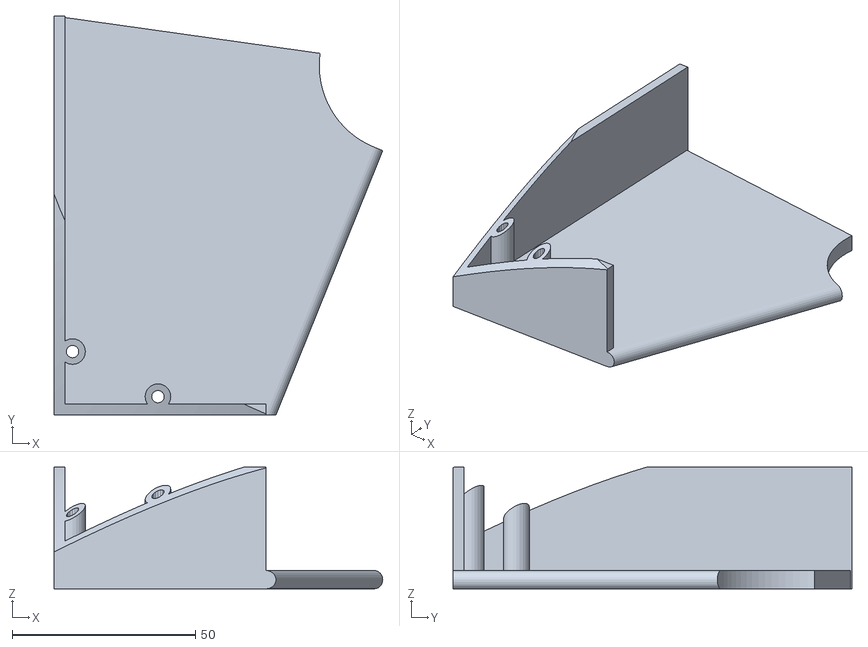
[picture p58: CAD file, 2026-10-04]
imprimir/hood.stl
89.6 x 108.8 x 33.2
