ipaud/bolabol/imprimir/llits/llit_04_menta.3mf

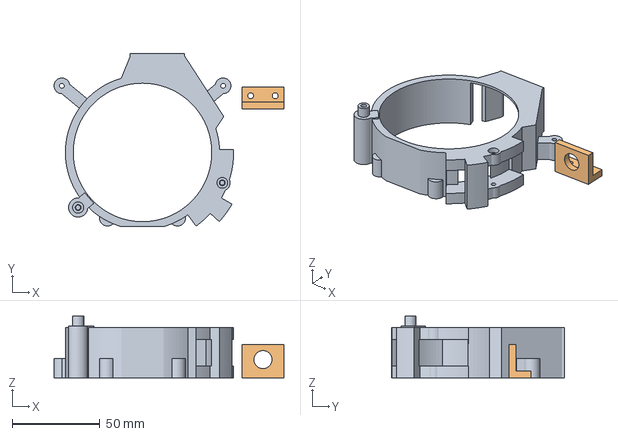
[picture p59: CAD file, 2026-10-04]
imprimir/llits/llit_04_menta.3mf
131.2 x 98.8 x 35.3 mm
coin_housing
deck_bracket
