ipaud/bolabol/stl/outlet_door.stl

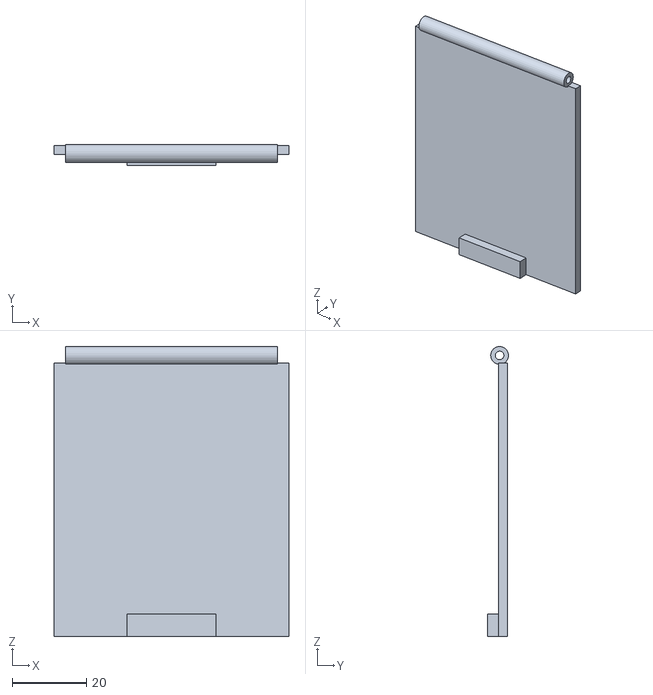
[picture p60: CAD file, 2026-10-04]
stl/outlet_door.stl
63.0 x 5.65 x 77.9
