ipaud/bolabol/imprimir/llits/llit_09_mecanisme.3mf

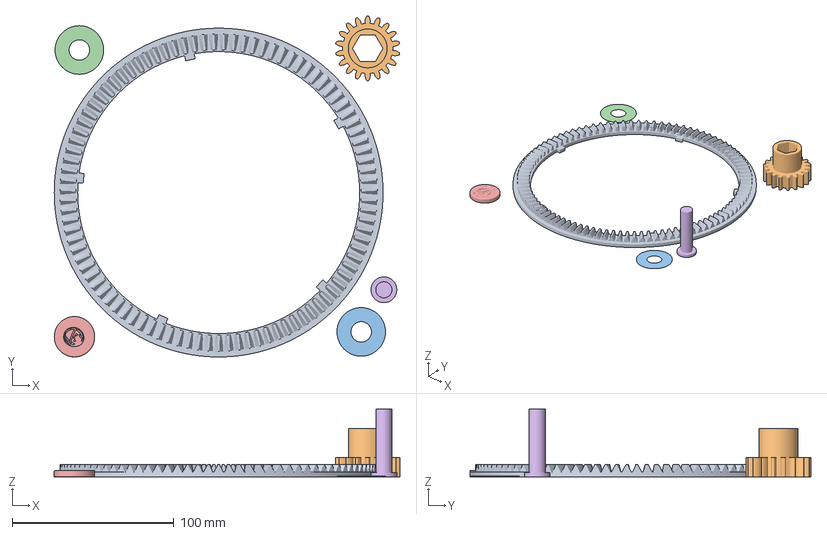
[picture p61: CAD file, 2026-10-04]
imprimir/llits/llit_09_mecanisme.3mf
213.3 x 210.5 x 41.7 mm
crown_ring
gear_A
shim_04
spare_shim_02
token_0
pinion_axle
