ipaud/bolabol/imprimir/shim_04.stl

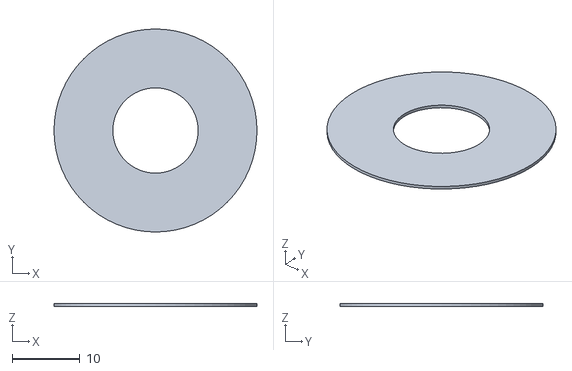
[picture p62: CAD file, 2026-10-04]
imprimir/shim_04.stl
30.0 x 30.0 x 0.39
