ipaud/bolabol/imprimir/pinion_axle.stl

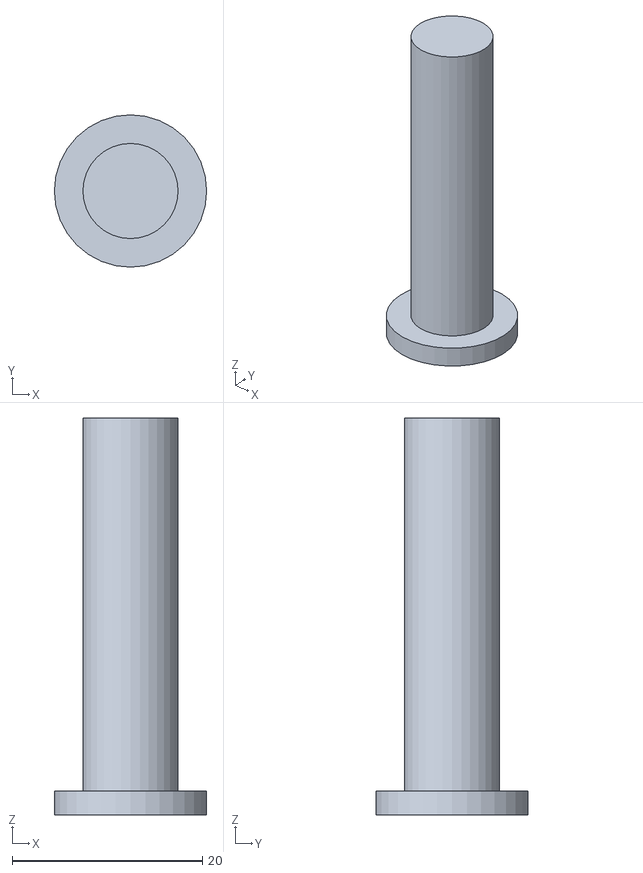
[picture p63: CAD file, 2026-10-04]
imprimir/pinion_axle.stl
16.0 x 16.0 x 41.7
