ipaud/bolabol/stl/spare_shim_02.stl

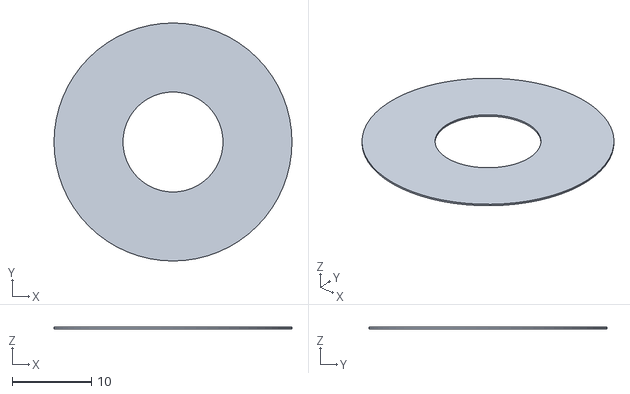
[picture p64: CAD file, 2026-10-04]
stl/spare_shim_02.stl
30.0 x 30.0 x 0.2
