ipaud/bolabol/imprimir/knob.stl

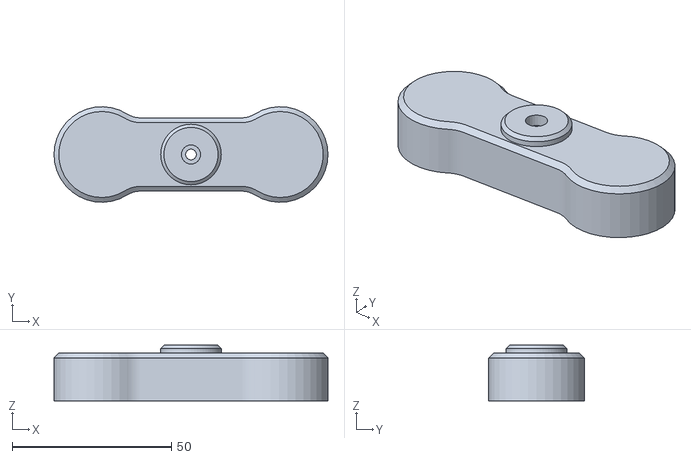
[picture p65: CAD file, 2026-10-04]
imprimir/knob.stl
86.0 x 30.0 x 17.5
