ipaud/bolabol/imprimir/llits/llit_08_corall.3mf

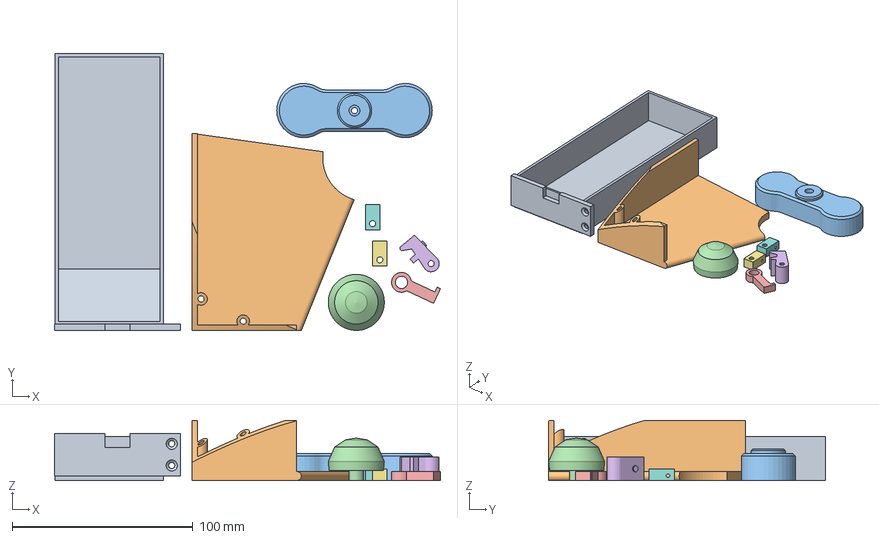
[picture p66: CAD file, 2026-10-04]
imprimir/llits/llit_08_corall.3mf
213.3 x 153.1 x 33.2 mm
token_drawer
hood
knob
topper
ratchet_pawl
dog_pawl
door_ear_0
door_ear_1
