ipaud/bolabol/imprimir/gear_B_pinion.stl

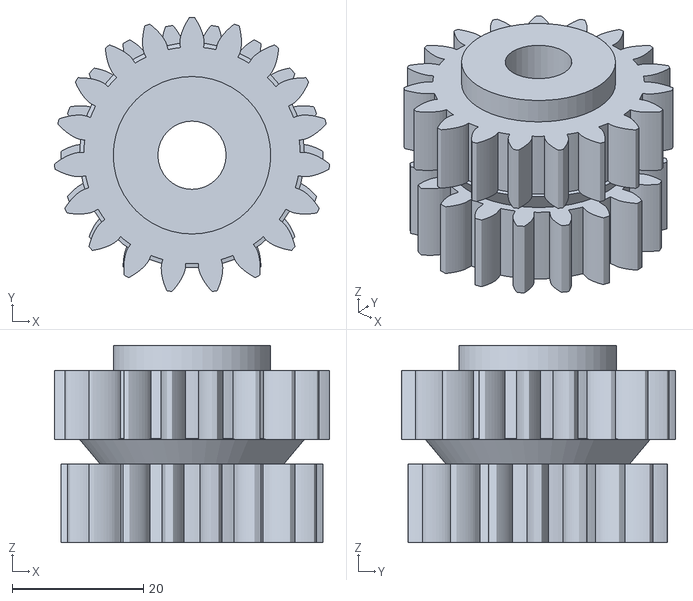
[picture p67: CAD file, 2026-10-04]
imprimir/gear_B_pinion.stl
41.9 x 41.8 x 30.1
