ipaud/bolabol/imprimir/ratchet_pawl.stl

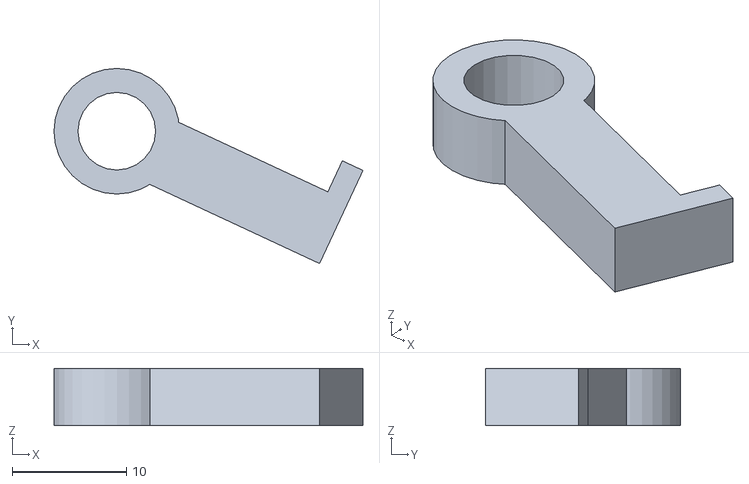
[picture p68: CAD file, 2026-10-04]
imprimir/ratchet_pawl.stl
27.1 x 17.1 x 5.00
