ipaud/bolabol/stl/topper.stl

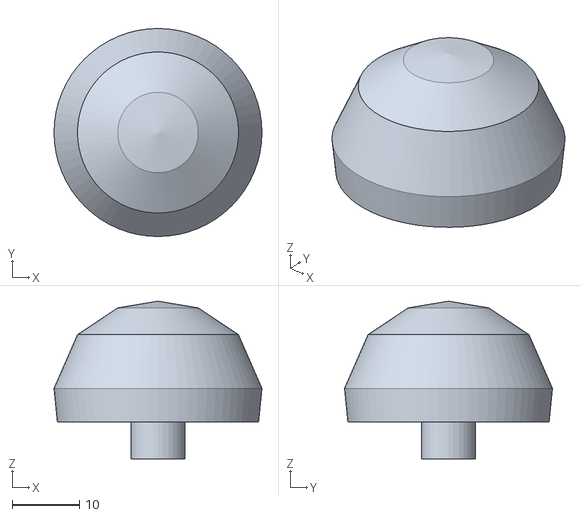
[picture p69: CAD file, 2026-10-04]
stl/topper.stl
31.0 x 31.0 x 23.5
