ipaud/bolabol/stl/sleeve_rear.stl

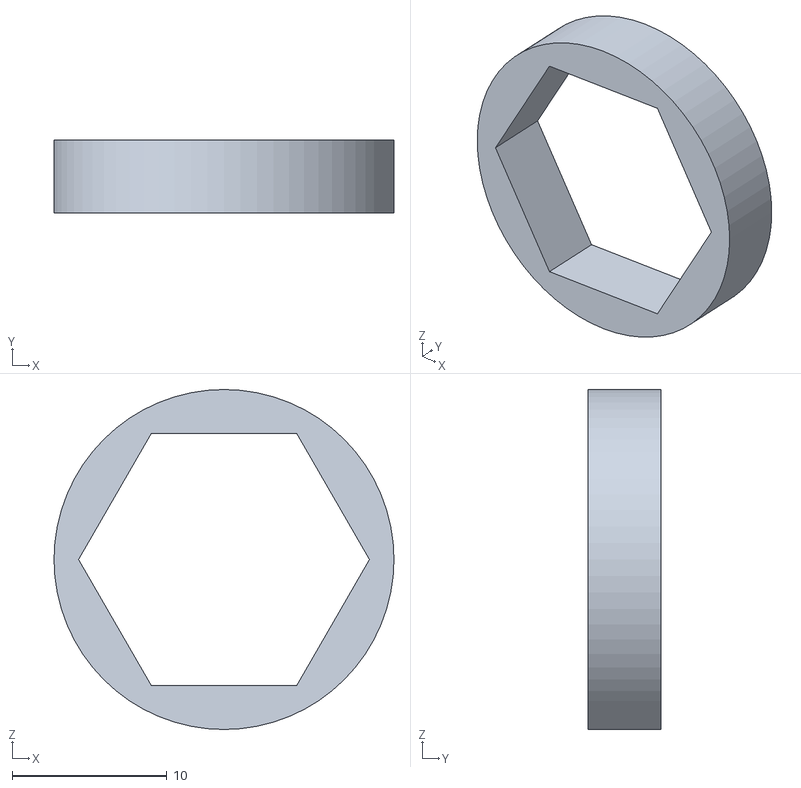
[picture p70: CAD file, 2026-10-04]
stl/sleeve_rear.stl
22.0 x 4.70 x 22.0
