ipaud/bolabol/stl/rotor.stl

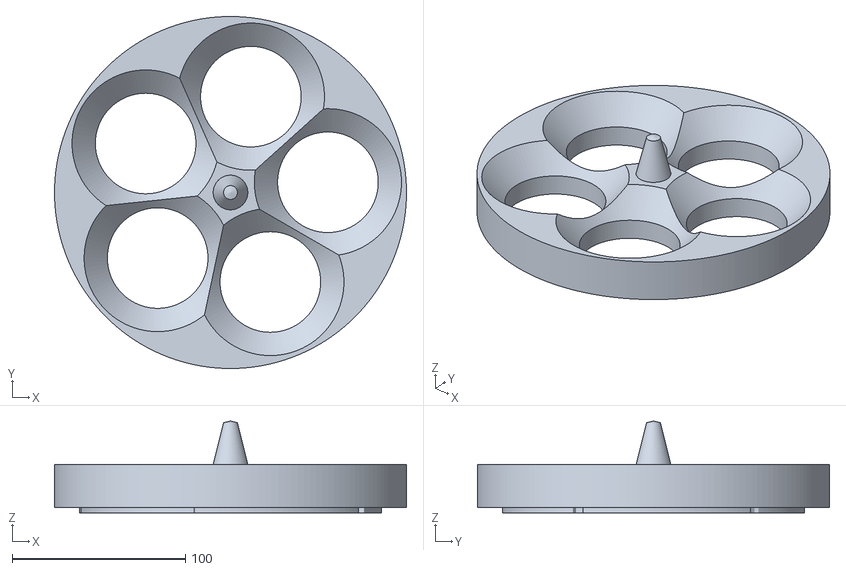
[picture p71: CAD file, 2026-10-04]
stl/rotor.stl
203.0 x 203.0 x 53.0
