ipaud/bolabol/imprimir/capsule_top_x10.stl

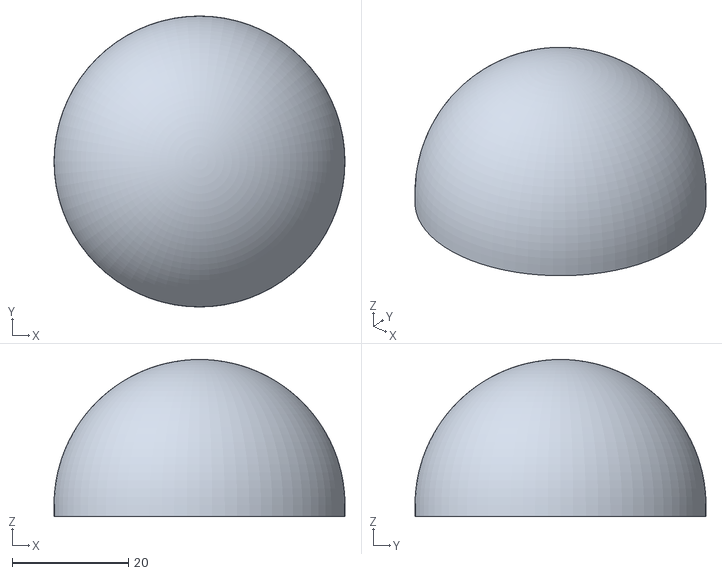
[picture p72: CAD file, 2026-10-04]
imprimir/capsule_top_x10.stl
50.0 x 50.0 x 27.0
