ipaud/bolabol/imprimir/door_ear_1.stl

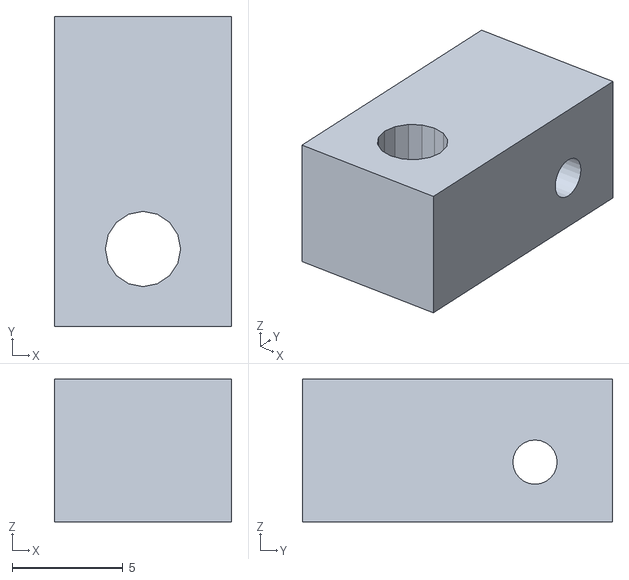
[picture p73: CAD file, 2026-10-04]
imprimir/door_ear_1.stl
8.00 x 14.0 x 6.45
