ipaud/bolabol/imprimir/spare_shim_06.stl

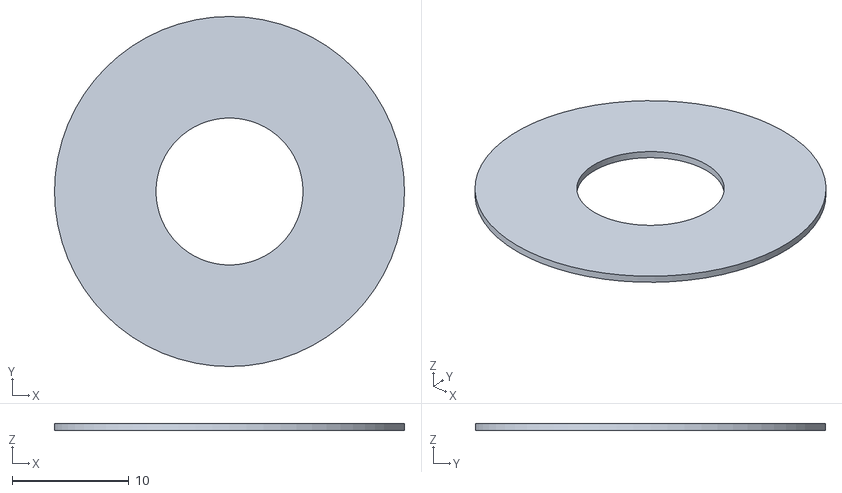
[picture p74: CAD file, 2026-10-04]
imprimir/spare_shim_06.stl
30.0 x 30.0 x 0.6
