ipaud/bolabol/imprimir/deck_bracket.stl

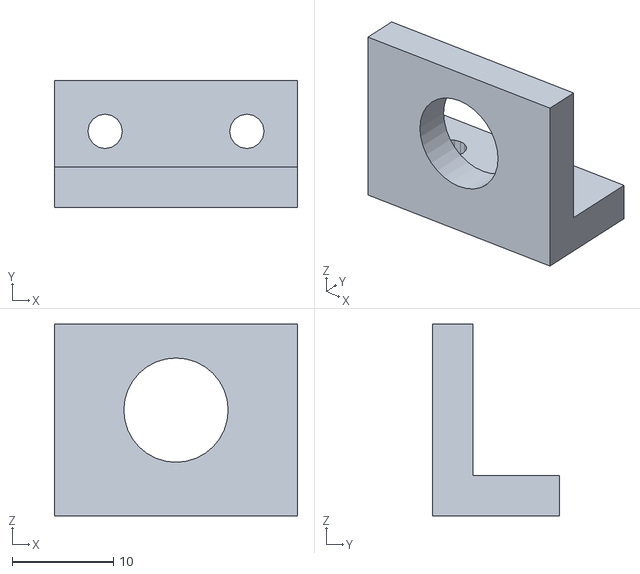
[picture p75: CAD file, 2026-10-04]
imprimir/deck_bracket.stl
24.0 x 12.5 x 18.9
