ipaud/bolabol/stl/dog_pawl.stl

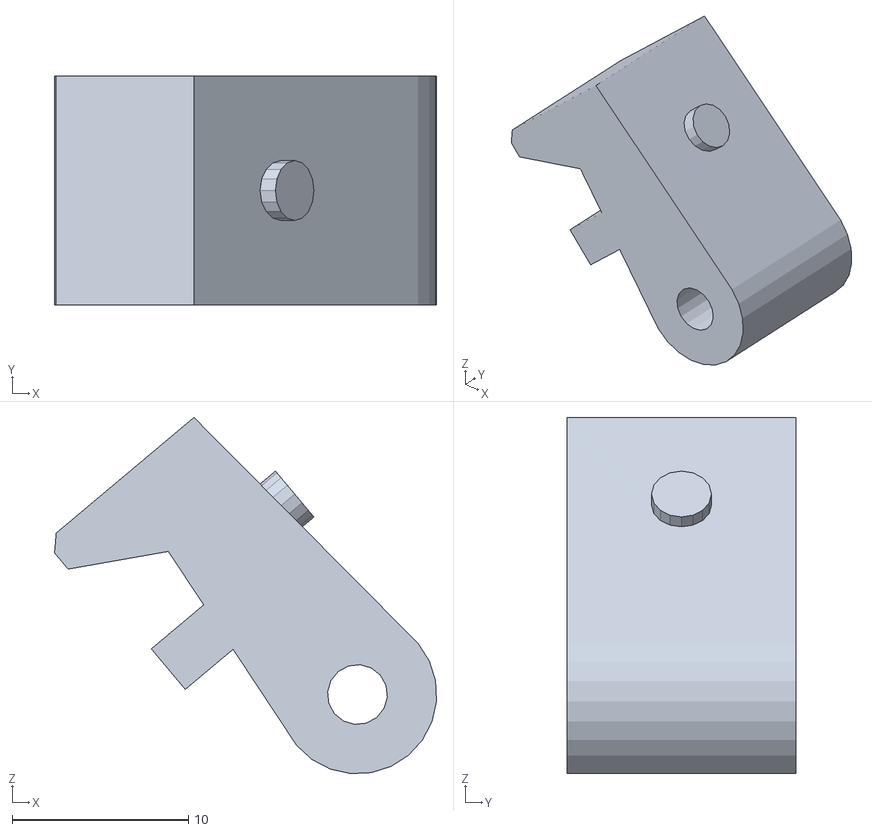
[picture p76: CAD file, 2026-10-04]
stl/dog_pawl.stl
21.7 x 13.0 x 20.2
