ipaud/bolabol/stl/coin_wheel.stl

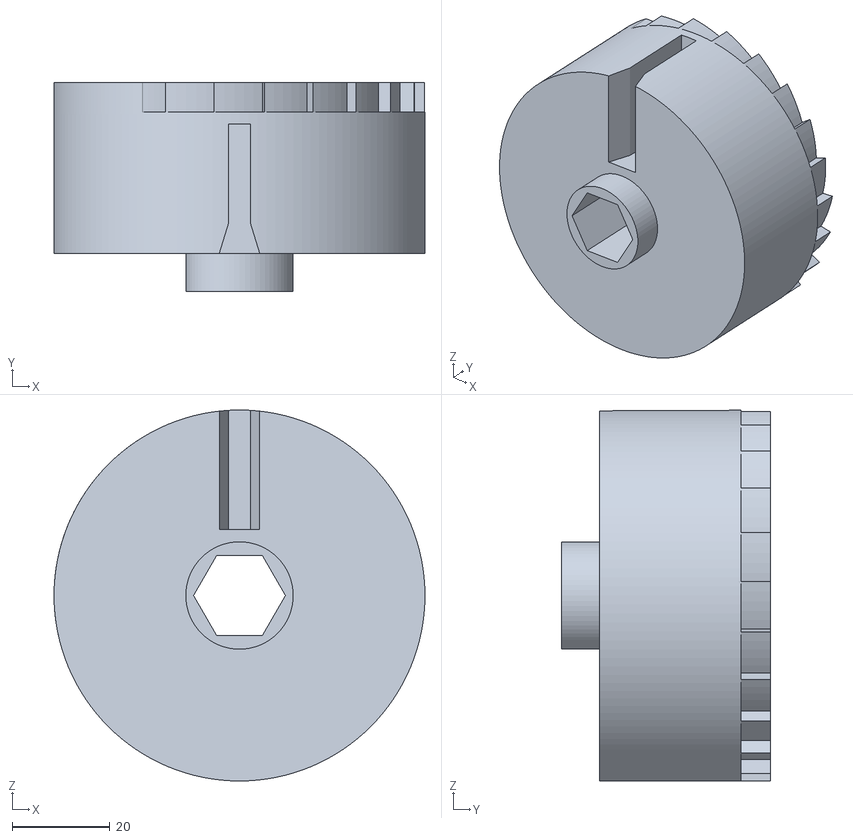
[picture p77: CAD file, 2026-10-04]
stl/coin_wheel.stl
76.0 x 42.8 x 76.0
