ipaud/bolabol/stl/knob.stl

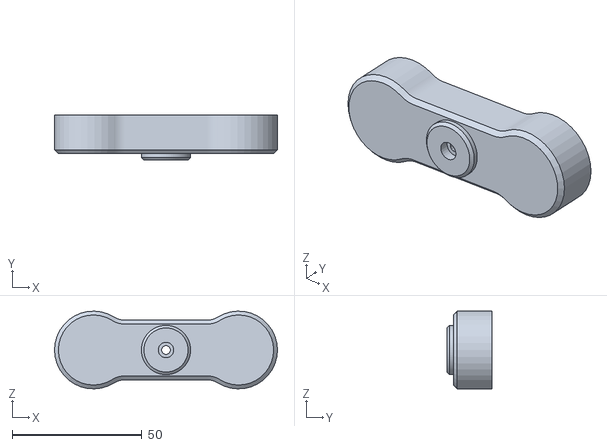
[picture p78: CAD file, 2026-10-04]
stl/knob.stl
86.0 x 17.5 x 30.0
