ipaud/bolabol/stl/hex_shaft.stl

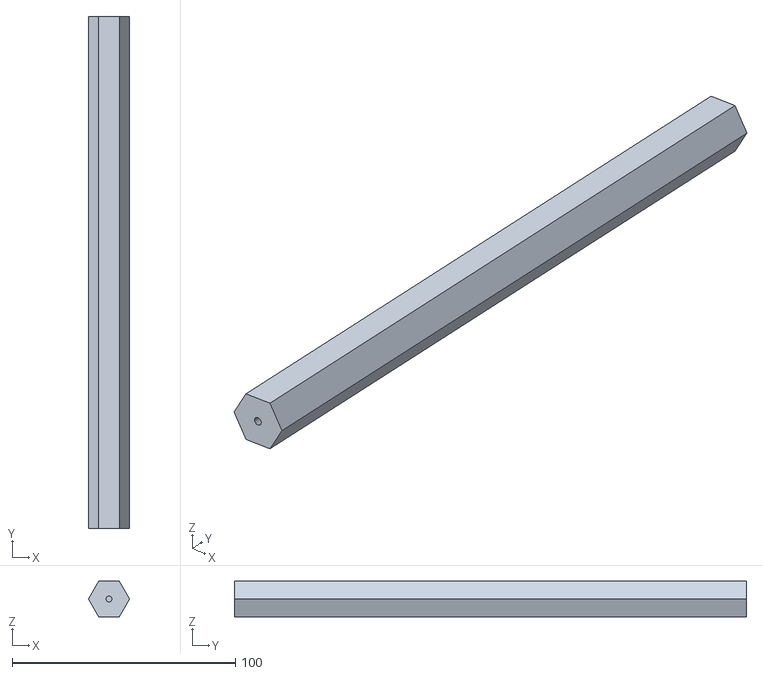
[picture p79: CAD file, 2026-10-04]
stl/hex_shaft.stl
18.5 x 229.4 x 16.0
