ipaud/bolabol/(list of files, cad)

Other CAD files:
imprimir/mech_box.stl
2monedes/proves/proves_6_moneda_B.3mf
imprimir/gear_A.stl
stl/coin_plate.stl
2monedes/proves/proves_5_moneda_A.3mf
stl/proves/proves_6_moneda_B_PLA.3mf
stl/token_drawer.stl
imprimir/coin_plate.stl
stl/logo_sparkles_coral.stl
stl/proves/proves_5_moneda_A_PLA.3mf
stl/proves/proves_5_moneda_A.3mf
stl/window_left.stl
imprimir/llits/llit_06_crema.3mf
stl/proves/test_coin_jig.stl
imprimir/llits/llit_01_menta.3mf
imprimir/pillar_0.stl
imprimir/pillar_3.stl
stl/mech_box.stl
imprimir/chute.stl
stl/deck.stl
stl/pillar_3.stl
stl/capsule_bottom.stl
imprimir/llits/llit_05_crema.3mf
imprimir/logo.stl
stl/pillar_0.stl
imprimir/llits/llit_02_menta.3mf
imprimir/llits/llit_17_menta.3mf
stl/logo_sparkles_mint.stl
imprimir/foot_3.stl
stl/pillar_1.stl
stl/bolabol_logo.3mf
imprimir/spacer.stl
imprimir/foot_1.stl
stl/window_back.stl
imprimir/window_left.stl
stl/foot_0.stl
stl/foot_3.stl
stl/spare_shim_06.stl
imprimir/crown_ring.stl
stl/window_front.stl
imprimir/window_right.stl
stl/funnel.stl
imprimir/door_ear_0.stl
stl/gear_B_pinion.stl
imprimir/spare_shim_02.stl
stl/capsule_top.stl
imprimir/logo_sparkles_coral.stl
imprimir/dog_pawl.stl
imprimir/rotor.stl
imprimir/topper.stl
stl/hood.stl
imprimir/pillar_1.stl
stl/chute.stl
imprimir/token_0_x6.stl
stl/coin_housing.stl
imprimir/deck.stl
stl/ratchet_pawl.stl
imprimir/foot_2.stl
stl/pinion_axle.stl
imprimir/coin_wheel.stl
stl/door_ear_1.stl
imprimir/pillar_2.stl
stl/foot_2.stl
imprimir/outlet_door.stl
stl/lid.stl
imprimir/sleeve_rear.stl
stl/logo_sparkles_yellow.stl
imprimir/logo_sparkles_yellow.stl
stl/window_right.stl
imprimir/foot_0.stl
stl/logo.stl
imprimir/window_back.stl
stl/shim_04.stl
imprimir/base_box.stl
stl/deck_bracket.stl
stl/door_ear_0.stl
BolaBol-v1.blend
BolaBol-v1_2monedes.blend
BolaBol-v1_duo.blend
