ipaud/bolabol/docs/assembly/coin/paso_1.jpg

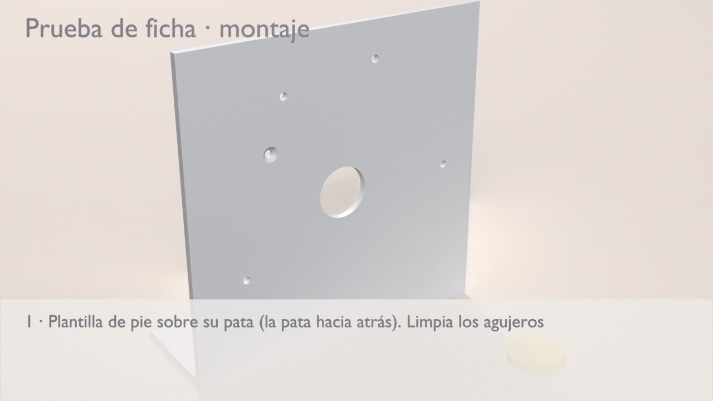
docs/assembly/coin/paso_1.jpg
