ipaud/bolabol/docs/assembly/coin/paso_2.jpg

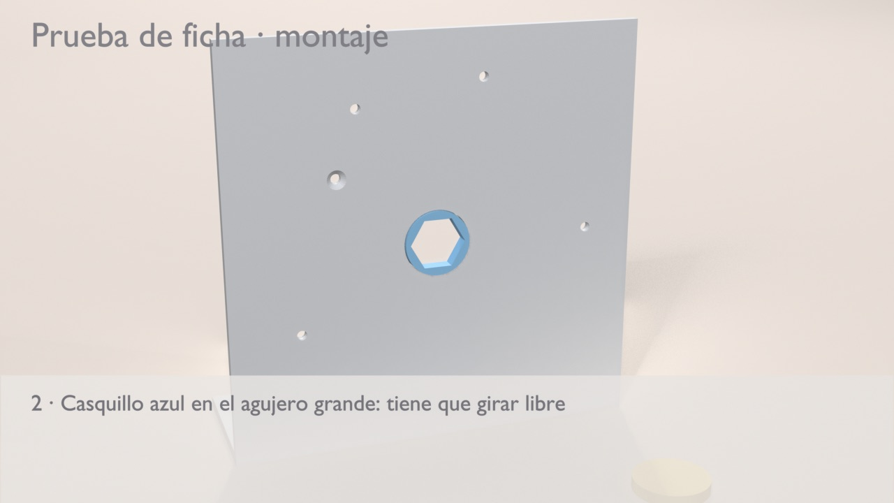
docs/assembly/coin/paso_2.jpg
