ipaud/bolabol/docs/assembly/coin/paso_3.jpg

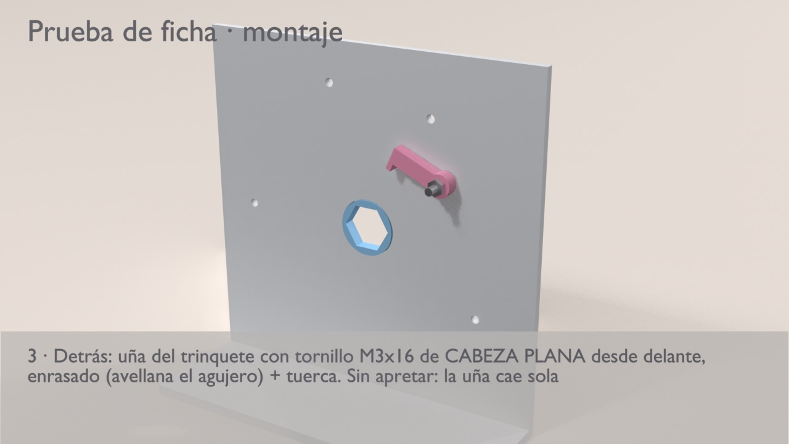
docs/assembly/coin/paso_3.jpg
