ipaud/bolabol/docs/assembly/coin/paso_4.jpg

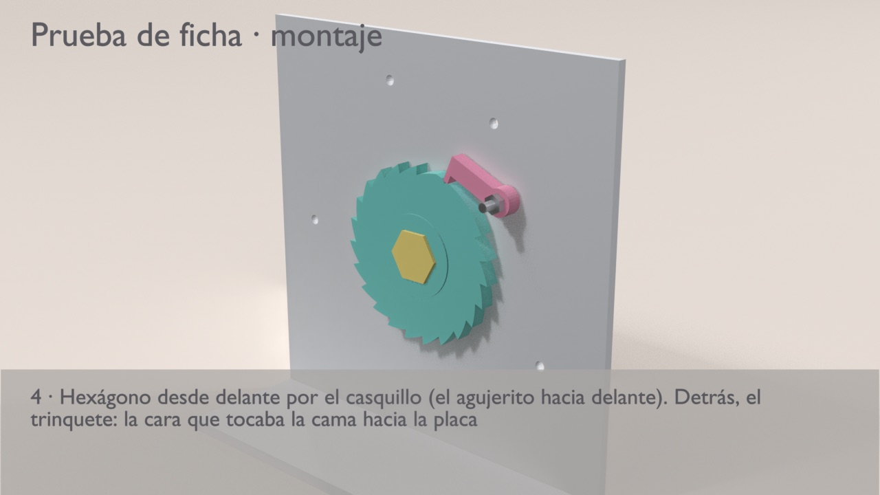
docs/assembly/coin/paso_4.jpg
