ipaud/bolabol/docs/assembly/coin/paso_5.jpg

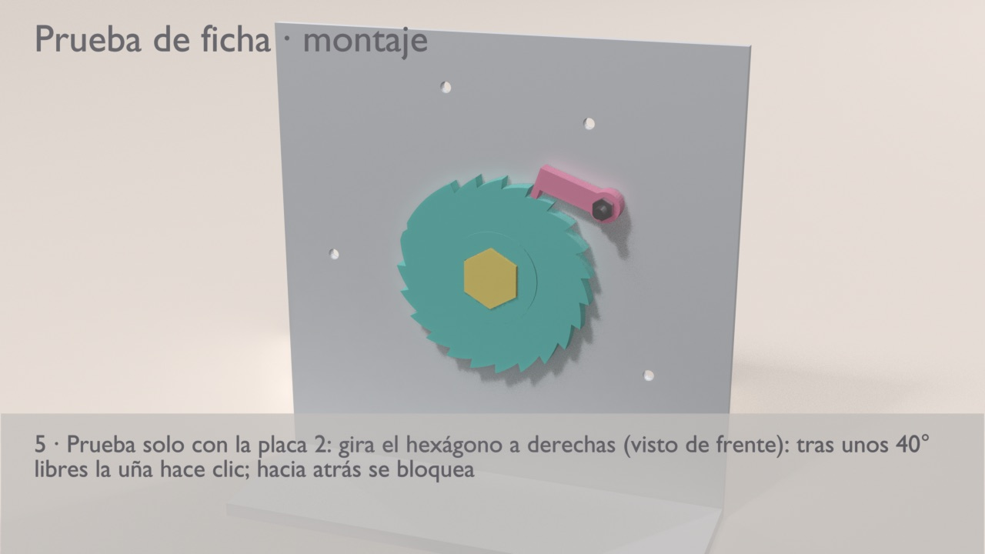
docs/assembly/coin/paso_5.jpg
