ipaud/bolabol/docs/assembly/coin/paso_6.jpg

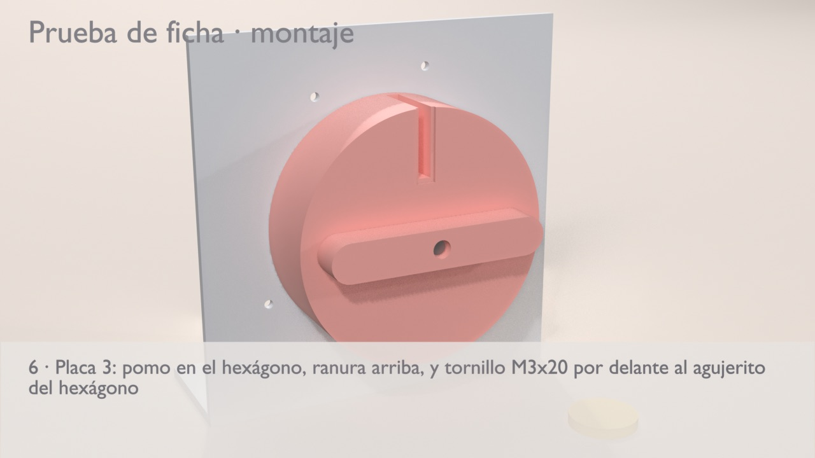
docs/assembly/coin/paso_6.jpg
