ipaud/bolabol/docs/assembly/coin/paso_7.jpg

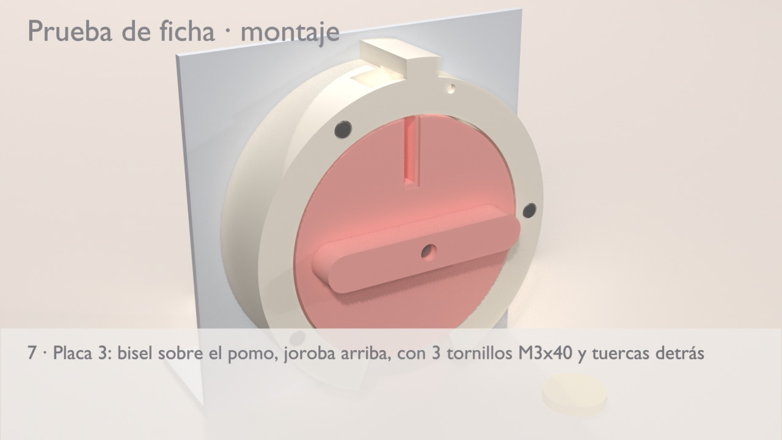
docs/assembly/coin/paso_7.jpg
