ipaud/bolabol/docs/assembly/coin/paso_8.jpg

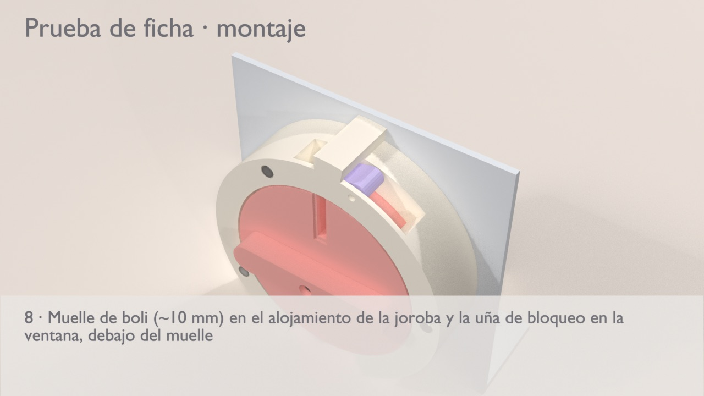
docs/assembly/coin/paso_8.jpg
