ipaud/bolabol/docs/assembly/coin/paso_9.jpg

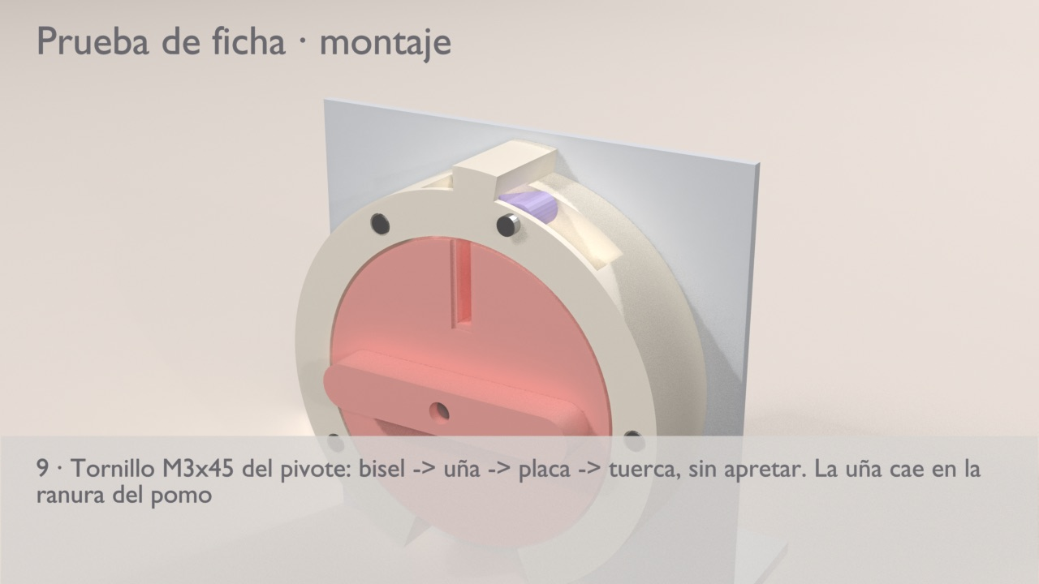
docs/assembly/coin/paso_9.jpg
