ipaud/bolabol/docs/assembly/coin/paso_10.jpg

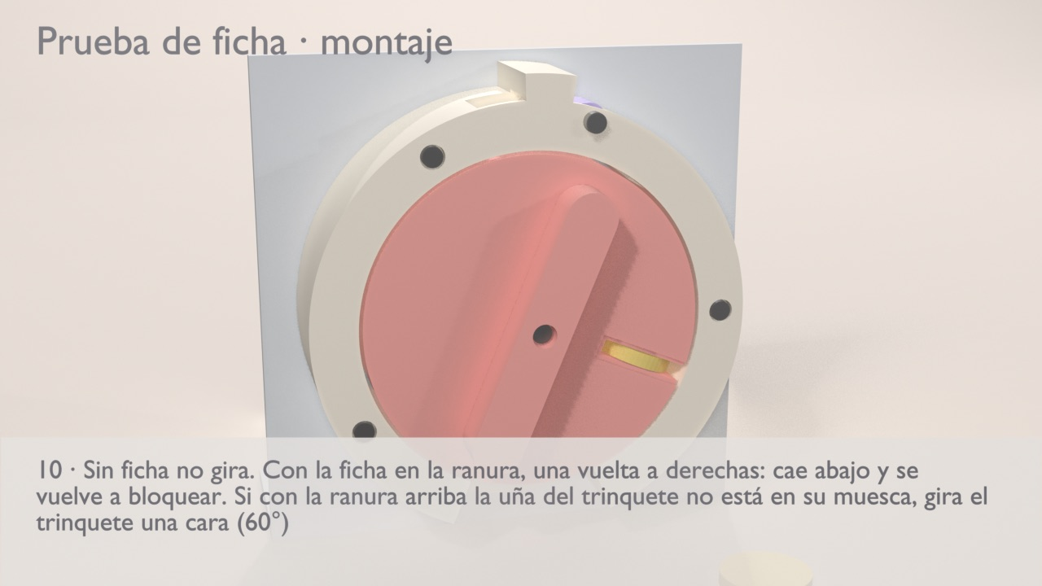
docs/assembly/coin/paso_10.jpg
