ipaud/bolabol/docs/assembly/gears/pas_1.jpg

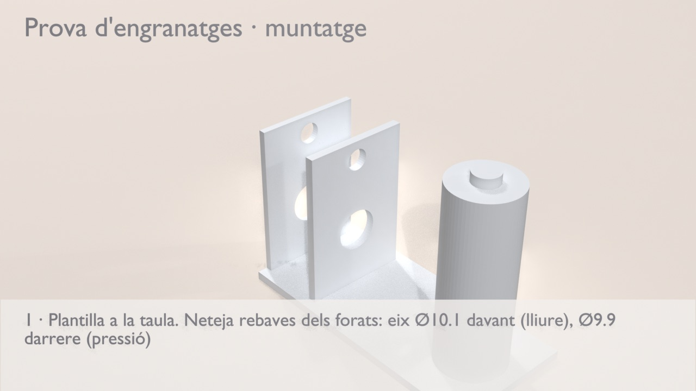
docs/assembly/gears/pas_1.jpg
