ipaud/bolabol/docs/assembly/gears/pas_2.jpg

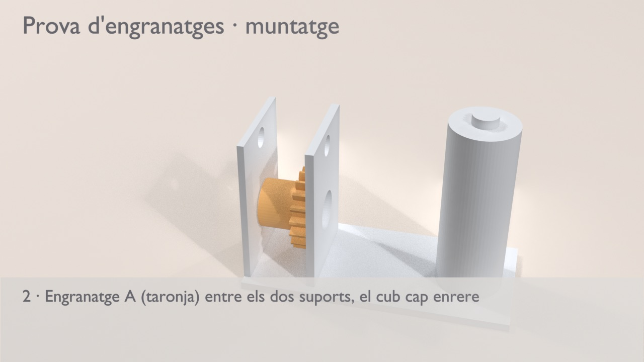
docs/assembly/gears/pas_2.jpg
