ipaud/bolabol/docs/assembly/gears/pas_3.jpg

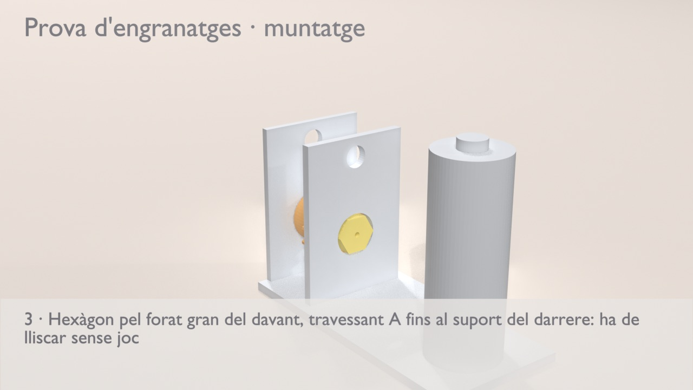
docs/assembly/gears/pas_3.jpg
