ipaud/bolabol/docs/assembly/gears/pas_4.jpg

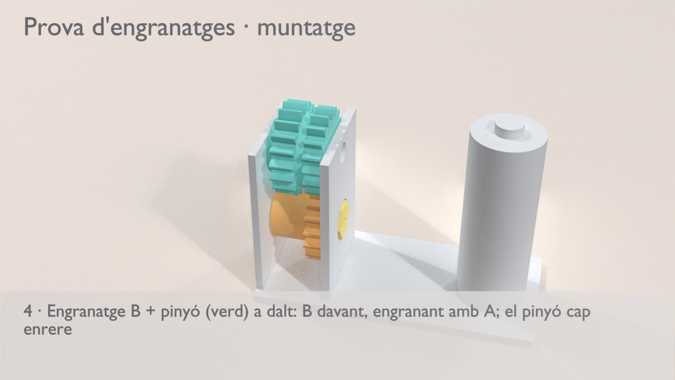
docs/assembly/gears/pas_4.jpg
