ipaud/bolabol/docs/assembly/gears/pas_5.jpg

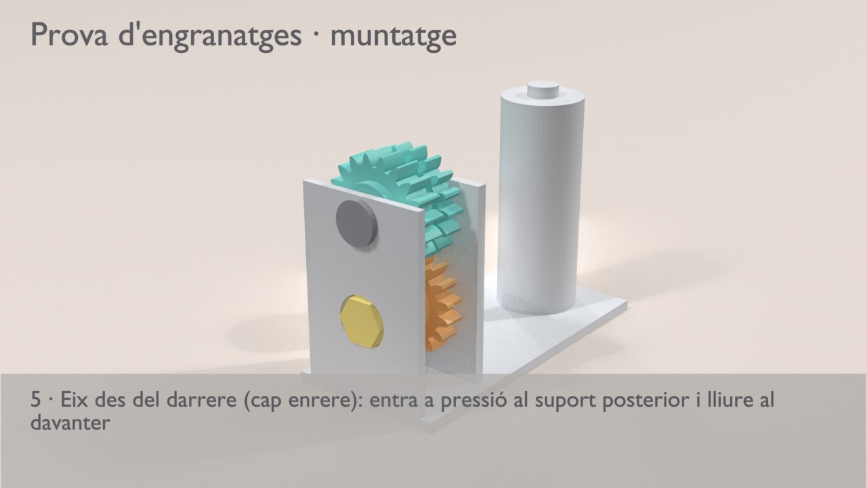
docs/assembly/gears/pas_5.jpg
