ipaud/bolabol/docs/assembly/gears/pas_6.jpg

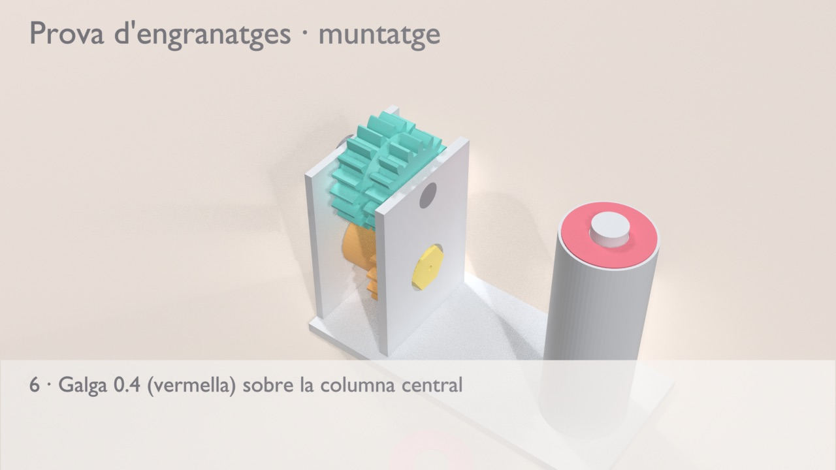
docs/assembly/gears/pas_6.jpg
