ipaud/bolabol/docs/assembly/gears/pas_7.jpg

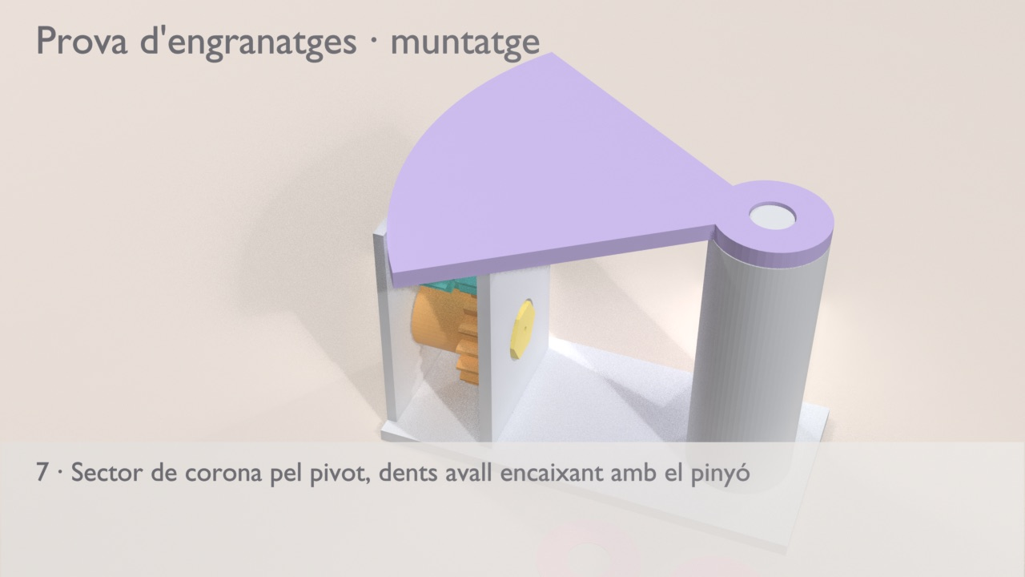
docs/assembly/gears/pas_7.jpg
