ipaud/bolabol/docs/assembly/gears/pas_8.jpg

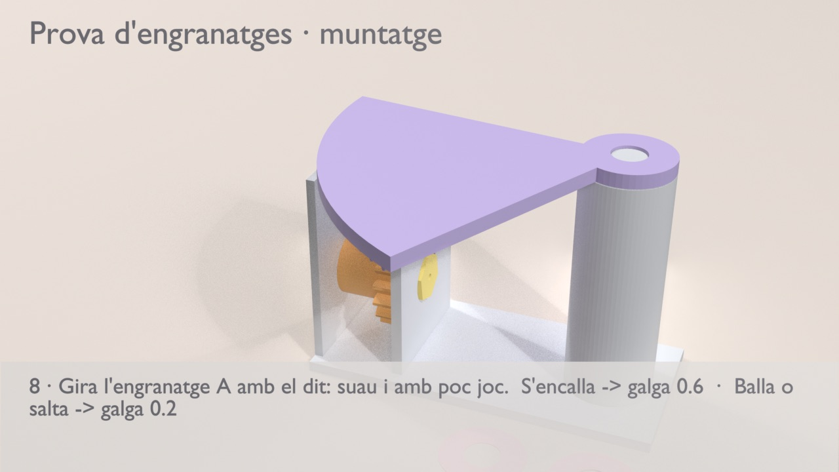
docs/assembly/gears/pas_8.jpg
