ipaud/bolabol/docs/brand/manual-de-marca.jpg

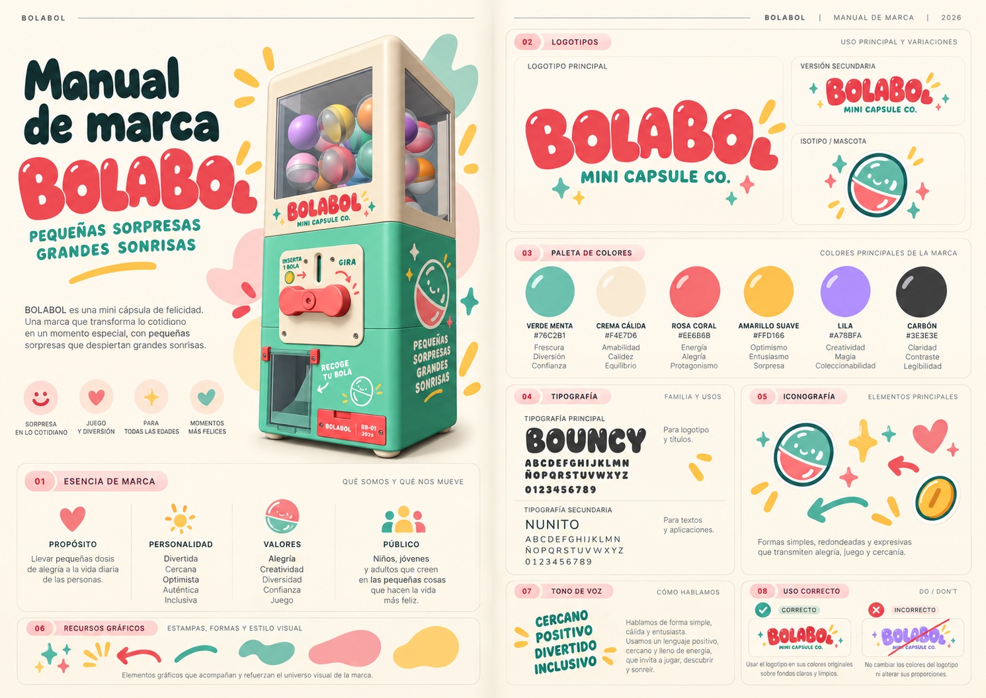
docs/brand/manual-de-marca.jpg
